azonenberg/stm32mp2-baremetal-tests/pcb/mp2-xc7k-test/mp2-xc7k-test.kicad_pcb

## KiCad design pcb/mp2-xc7k-test/mp2-xc7k-test.kicad_pcb (2025-12-23)

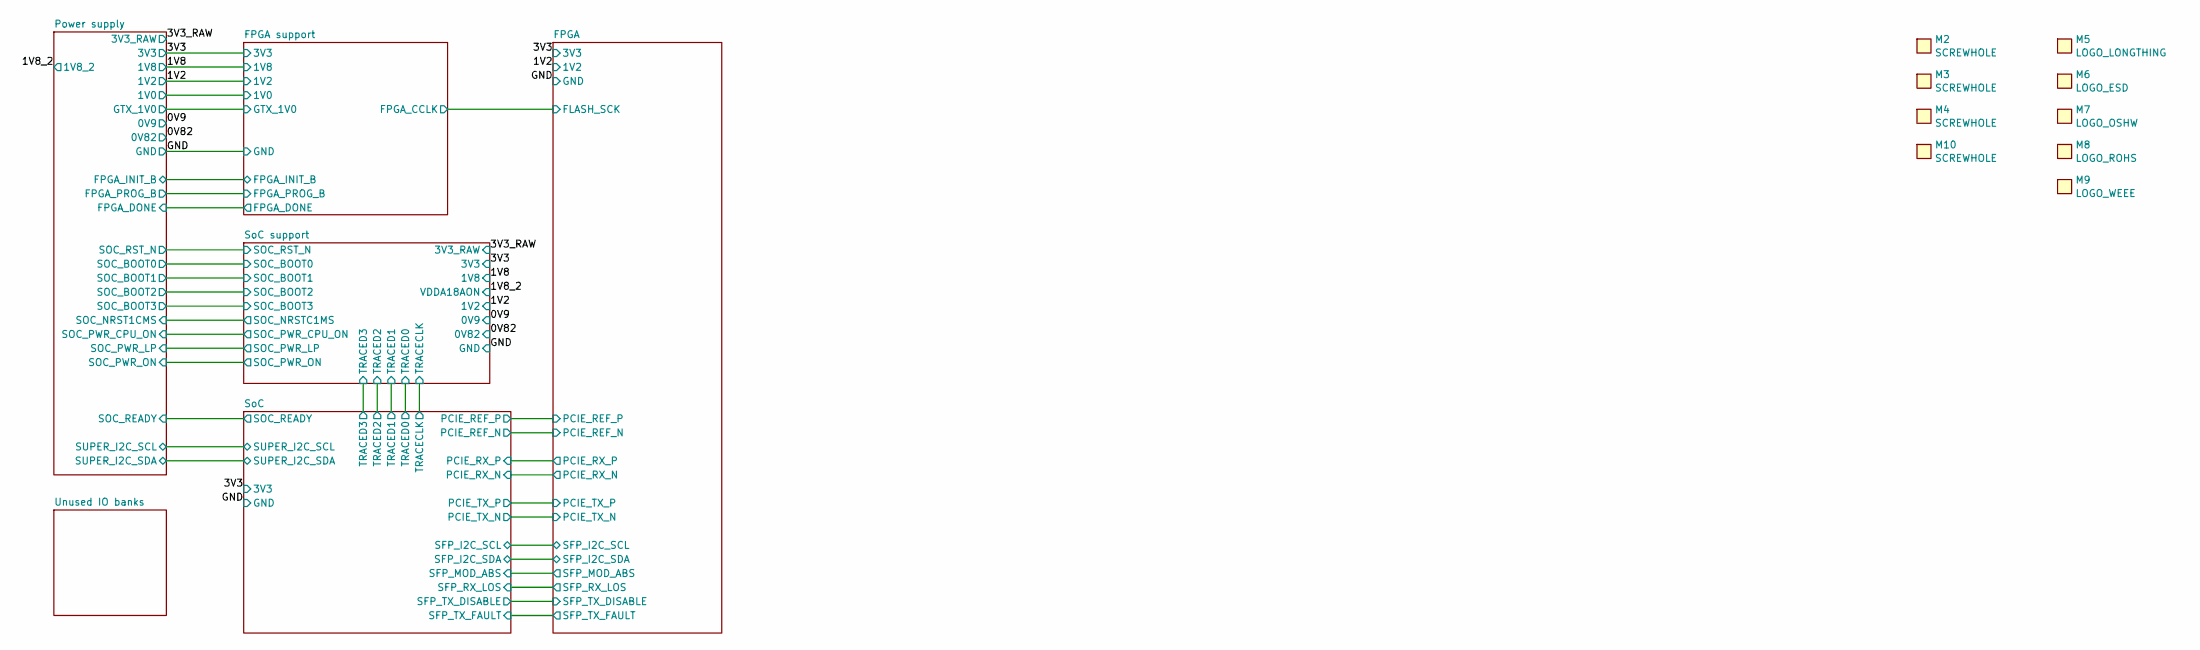
[picture p1: schematic mp2-xc7k-test.kicad_sch]

Parts:
M2, M3, M4, M10: SCREWHOLE; MECHANICAL_CLEARANCEHOLE_4_40
M5: LOGO_LONGTHING; LONGTHING-1200DPI
M6: LOGO_ESD; LOGO_ESD_SENSITIVE_7MM
M7: LOGO_OSHW; Logo_silk_OSHW_6x6mm
M8: LOGO_ROHS; Logo_silk_ROHS_5x2.8mm
M9: LOGO_WEEE; Logo_silk_WEEE_3.4x5mm

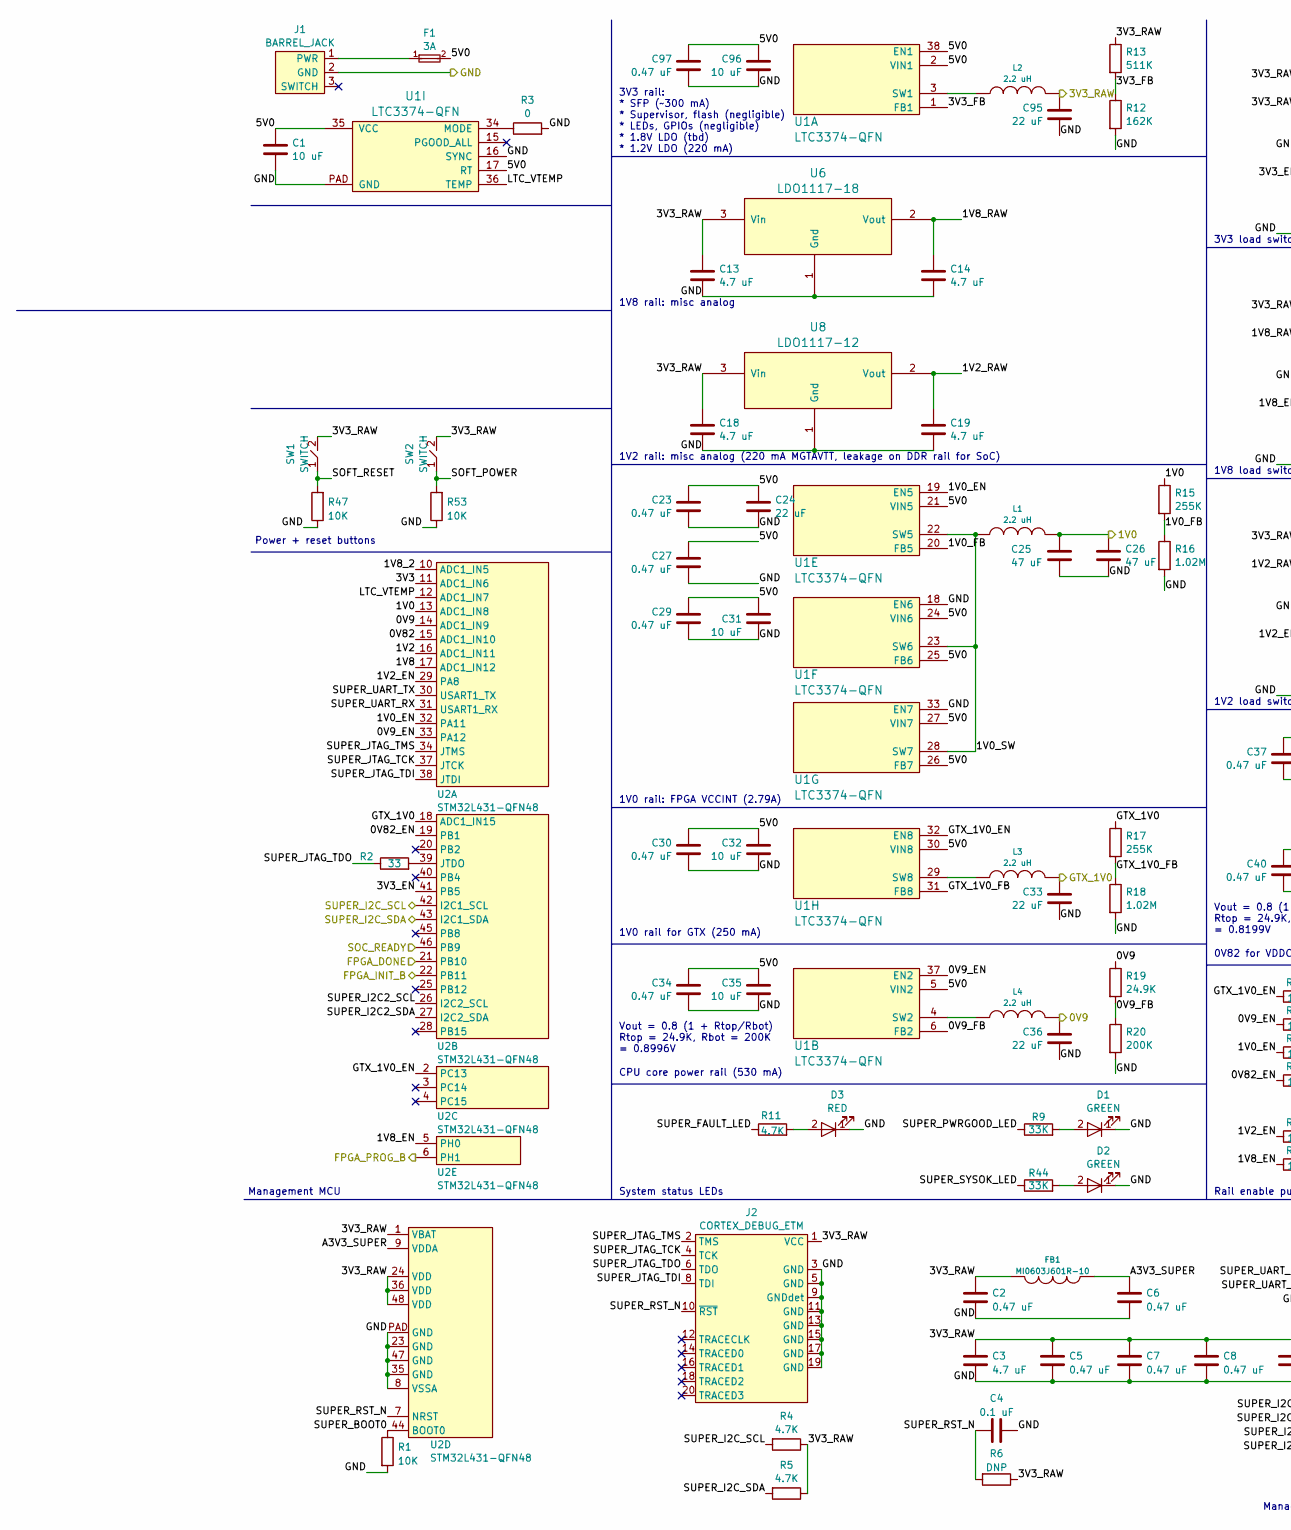
[picture p2: schematic psu.kicad_sch, part in row 1, column 1]

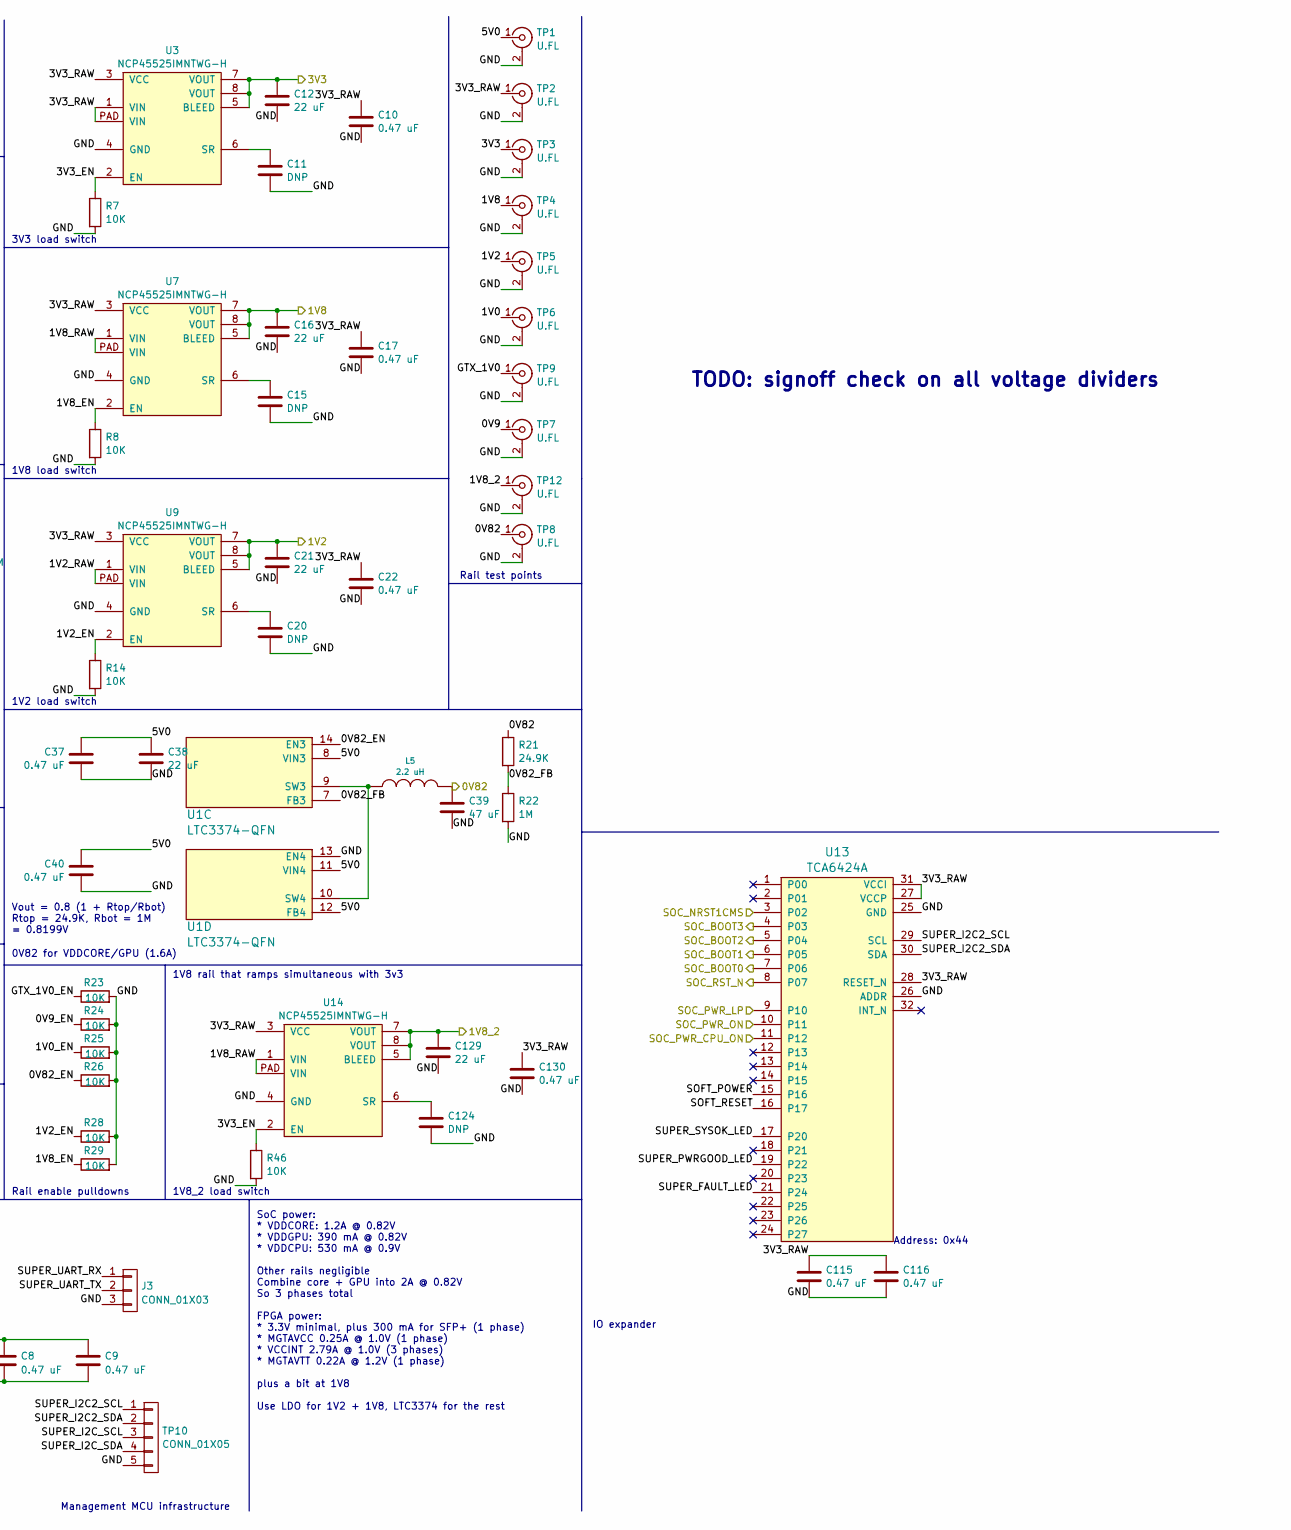
[picture p3: schematic psu.kicad_sch, part in row 1, column 2]

Parts:
C1, C31, C32, C35, C96: 10 uF; EIA_1210_CAP_NOSILK
C2, C5, C6, C7, C8, C9, C10, C17, C22, C23, C27, C29, C30, C34, C37, C40, C97, C115, C116, C130: 0.47 uF; EIA_0402_CAP_NOSILK
C3, C13, C14, C18, C19: 4.7 uF; EIA_0603_CAP_NOSILK
C4: 0.1 uF; EIA_0402_CAP_NOSILK
C11, C15, C20, C124: DNP; EIA_0402_CAP_NOSILK
C12, C16, C21, C24, C38, C129: 22 uF; EIA_1210_CAP_NOSILK
C25, C26, C39: 47 uF; EIA_1206_CAP_NOSILK
C33, C36, C95: 22 uF; EIA_1206_CAP_NOSILK
D1, D2: GREEN; EIA_0402_LED
D3: RED; EIA_0402_LED
F1: 3A; EIA_0402_RES_NOSILK
FB1: MI0603J601R-10; EIA_0603_INDUCTOR_NOSILK
J1: BARREL_JACK; CONN_CUI_PJ-058BH_HIPWR_BARREL_NOSLOT
J2: CORTEX_DEBUG_ETM; CONN_HEADER_1.27MM_2x10_SMT_SAMTEC_FTSH-110-01-L-DV-K
J3: CONN_01X03; CONN_HEADER_2.54MM_1x3
L1, L2, L3, L4, L5: 2.2 uH; EIA_1210_CAP_NOSILK
R1, R7, R8, R14, R23, R24, R25, R26, R28, R29, R46, R47, R53: 10K; EIA_0402_RES_NOSILK
R2: 33; EIA_0402_RES_NOSILK
R3: 0; EIA_0402_RES_NOSILK
R4, R5, R11: 4.7K; EIA_0402_RES_NOSILK
R6: DNP; EIA_0402_RES_NOSILK
R9, R44: 33K; EIA_0402_RES_NOSILK
R12: 162K; EIA_0402_RES_NOSILK
R13: 511K; EIA_0402_RES_NOSILK
R15, R17: 255K; EIA_0402_RES_NOSILK
R16, R18: 1.02M; EIA_0402_RES_NOSILK
R19, R21: 24.9K; EIA_0402_RES_NOSILK
R20: 200K; EIA_0402_RES_NOSILK
R22: 1M; EIA_0402_RES_NOSILK
SW1, SW2: SWITCH; SWITCH_RAFI_MICON_5
TP1, TP2, TP3, TP4, TP5, TP6, TP7, TP8, TP9, TP12: U.FL; CONN_U.FL_TE_1909763-1
TP10: CONN_01X05; CONN_HEADER_2.54MM_1x5_REFLOW
U1: LTC3374-QFN; QFN_38_0.5MM_5x7MM
U2: STM32L431-QFN48; QFN_48_0.5MM_7x7MM
U3, U7, U9, U14: NCP45525IMNTWG-H; DFN_8_0.5MM_2x2MM
U6: LDO1117-18; SOT223-4
U8: LDO1117-12; SOT223-4
U13: TCA6424A; QFN_32_0.5MM_5x5MM

Connections:
/0V9: C36.1, L4.1, R19.1, TP7.1 (In), U2.14 (ADC1_IN9); also elsewhere on the board
/0V82: C39.1, L5.1, R21.1, TP8.1 (In), U2.15 (ADC1_IN10); also elsewhere on the board
/1V2: C21.1, TP5.1 (In), U2.16 (ADC1_IN11), U9.5 (BLEED), U9.7 (VOUT), U9.8 (VOUT); also elsewhere on the board
/1V8: C16.1, TP4.1 (In), U2.17 (ADC1_IN12), U7.5 (BLEED), U7.7 (VOUT), U7.8 (VOUT); also elsewhere on the board
/1V8_2: C129.1, TP12.1 (In), U2.10 (ADC1_IN5), U14.5 (BLEED), U14.7 (VOUT), U14.8 (VOUT); also elsewhere on the board
/3V3: C12.1, TP3.1 (In), U2.11 (ADC1_IN6), U3.5 (BLEED), U3.7 (VOUT), U3.8 (VOUT); also elsewhere on the board
/3V3_RAW: C2.1, C3.1, C5.1, C7.1, C8.1, C9.1, C10.1, C13.1, C17.1, C18.1, C22.1, C95.1, C115.1, C116.1, C130.1, FB1.2, J2.1 (VCC), L2.2, R4.1, R5.1, R6.1, R13.1, SW1.2, SW2.2, TP2.1 (In), U2.1 (VBAT), U2.24 (VDD), U2.36 (VDD), U2.48 (VDD), U3.1 (VIN), U3.3 (VCC), U3.PAD (VIN), U6.3 (Vin), U7.3 (VCC), U8.3 (Vin), U9.3 (VCC), U13.27 (VCCP), U13.28 (RESET_N), U13.31 (VCCI), U14.3 (VCC); also elsewhere on the board
/FPGA support/1V0: C25.1, C26.1, L1.1, R15.1, TP6.1 (In), U2.13 (ADC1_IN8); also elsewhere on the board
/FPGA support/FPGA_DONE: U2.21 (PB10); also elsewhere on the board
/FPGA support/FPGA_INIT_B: U2.22 (PB11); also elsewhere on the board
/FPGA support/FPGA_PROG_B: U2.6 (PH1); also elsewhere on the board
/FPGA support/GTX_1V0: C33.1, L3.1, R17.1, TP9.1 (In), U2.18 (ADC1_IN15); also elsewhere on the board
/GND: C1.2, C2.2, C3.2, C4.2, C5.2, C6.2, C7.2, C8.2, C9.2, C10.2, C11.2, C12.2, C13.2, C14.2, C15.2, C16.2, C17.2, C18.2, C19.2, C20.2, C21.2, C22.2, C23.2, C24.2, C25.2, C26.2, C27.2, C29.2, C30.2, C31.2, C32.2, C33.2, C34.2, C35.2, C36.2, C37.2, C38.2, C39.2, C40.2, C95.2, C96.2, C97.2, C115.2, C116.2, C124.2, C129.2, C130.2, D1.1 (K), D2.1 (K), D3.1 (K), J1.2 (GND), J2.3 (GND), J2.5 (GND), J2.9 (GNDdet), J2.11 (GND), J2.13 (GND), J2.15 (GND), J2.17 (GND), J2.19 (GND), J3.3, R1.2, R3.2, R7.2, R8.2, R12.2, R14.2, R16.2, R18.2, R20.2, R22.2, R23.2, R24.2, R25.2, R26.2, R28.2, R29.2, R46.2, R47.1, R53.1, TP1.2 (Ext), TP2.2 (Ext), TP3.2 (Ext), TP4.2 (Ext), TP5.2 (Ext), TP6.2 (Ext), TP7.2 (Ext), TP8.2 (Ext), TP9.2 (Ext), TP10.5, TP12.2 (Ext), U1.13 (EN4), U1.16 (SYNC), U1.18 (EN6), U1.33 (EN7), U1.PAD (GND), U2.8 (VSSA), U2.23 (GND), U2.35 (GND), U2.47 (GND), U2.PAD (GND), U3.4 (GND), U6.1 (Gnd), U7.4 (GND), U8.1 (Gnd), U9.4 (GND), U13.25 (GND), U13.26 (ADDR), U14.4 (GND); also elsewhere on the board
/Power supply/0V9_EN: R24.1, U1.37 (EN2), U2.33 (PA12)
/Power supply/0V9_FB: R19.2, R20.1, U1.6 (FB2)
/Power supply/0V82_EN: R26.1, U1.14 (EN3), U2.19 (PB1)
/Power supply/0V82_FB: R21.2, R22.1, U1.7 (FB3)
/Power supply/1V0_EN: R25.1, U1.19 (EN5), U2.32 (PA11)
/Power supply/1V0_FB: R15.2, R16.1, U1.20 (FB5)
/Power supply/1V0_SW: L1.2, U1.22 (SW5), U1.23 (SW6), U1.28 (SW7)
/Power supply/1V2_EN: R14.1, R28.1, U2.29 (PA8), U9.2 (EN)
/Power supply/1V2_RAW: C19.1, U8.2 (Vout), U9.1 (VIN), U9.PAD (VIN)
/Power supply/1V8_EN: R8.1, R29.1, U2.5 (PH0), U7.2 (EN)
/Power supply/1V8_RAW: C14.1, U6.2 (Vout), U7.1 (VIN), U7.PAD (VIN), U14.1 (VIN), U14.PAD (VIN)
/Power supply/3V3_EN: R7.1, R46.1, U2.41 (PB5), U3.2 (EN), U14.2 (EN)
/Power supply/3V3_FB: R12.1, R13.2, U1.1 (FB1)
/Power supply/5V0: C1.1, C23.1, C24.1, C27.1, C29.1, C30.1, C31.1, C32.1, C34.1, C35.1, C37.1, C38.1, C40.1, C96.1, C97.1, F1.2, TP1.1 (In), U1.2 (VIN1), U1.5 (VIN2), U1.8 (VIN3), U1.11 (VIN4), U1.12 (FB4), U1.17 (RT), U1.21 (VIN5), U1.24 (VIN6), U1.25 (FB6), U1.26 (FB7), U1.27 (VIN7), U1.30 (VIN8), U1.35 (VCC), U1.38 (EN1)
/Power supply/A3V3_SUPER: C6.1, FB1.1, U2.9 (VDDA)
/Power supply/GTX_1V0_EN: R23.1, U1.32 (EN8), U2.2 (PC13)
/Power supply/GTX_1V0_FB: R17.2, R18.1, U1.31 (FB8)
/Power supply/LTC_VTEMP: U1.36 (TEMP), U2.12 (ADC1_IN7)
/Power supply/SOC_BOOT0: U13.7 (P06); also elsewhere on the board
/Power supply/SOC_BOOT1: U13.6 (P05); also elsewhere on the board
/Power supply/SOC_BOOT2: U13.5 (P04); also elsewhere on the board
/Power supply/SOC_BOOT3: U13.4 (P03); also elsewhere on the board
/Power supply/SOC_NRST1CMS: U13.3 (P02); also elsewhere on the board
/Power supply/SOC_PWR_CPU_ON: U13.11 (P12); also elsewhere on the board
/Power supply/SOC_PWR_LP: U13.9 (P10); also elsewhere on the board
/Power supply/SOC_PWR_ON: U13.10 (P11); also elsewhere on the board
/Power supply/SOC_READY: U2.46 (PB9); also elsewhere on the board
/Power supply/SOFT_POWER: R53.2, SW2.1, U13.15 (P16)
/Power supply/SOFT_RESET: R47.2, SW1.1, U13.16 (P17)
/Power supply/SUPER_BOOT0: R1.1, U2.44 (BOOT0)
/Power supply/SUPER_FAULT_LED: R11.1, U13.21 (P24)
/Power supply/SUPER_I2C2_SCL: TP10.1, U2.26 (I2C2_SCL), U13.29 (SCL)
/Power supply/SUPER_I2C2_SDA: TP10.2, U2.27 (I2C2_SDA), U13.30 (SDA)
/Power supply/SUPER_I2C_SCL: R4.2, TP10.3, U2.42 (I2C1_SCL); also elsewhere on the board
/Power supply/SUPER_I2C_SDA: R5.2, TP10.4, U2.43 (I2C1_SDA); also elsewhere on the board
/Power supply/SUPER_JTAG_TCK: J2.4 (TCK), U2.37 (JTCK)
/Power supply/SUPER_JTAG_TDI: J2.8 (TDI), U2.38 (JTDI)
/Power supply/SUPER_JTAG_TDO: J2.6 (TDO), R2.1
/Power supply/SUPER_JTAG_TMS: J2.2 (TMS), U2.34 (JTMS)
/Power supply/SUPER_PWRGOOD_LED: R9.1, U13.19 (P22)
/Power supply/SUPER_RST_N: C4.1, J2.10 (~RST), R6.2, U2.7 (NRST)
/Power supply/SUPER_SYSOK_LED: R44.1, U13.17 (P20)
/Power supply/SUPER_UART_RX: J3.1, U2.31 (USART1_RX)
/Power supply/SUPER_UART_TX: J3.2, U2.30 (USART1_TX)
/SoC support/SOC_RST_N: U13.8 (P07); also elsewhere on the board
unnamed: D1.2 (A), R9.2
unnamed: D2.2 (A), R44.2
unnamed: D3.2 (A), R11.2
unnamed: F1.1, J1.1 (PWR)
unnamed: L2.1, U1.3 (SW1)
unnamed: L4.2, U1.4 (SW2)
unnamed: L5.2, U1.9 (SW3), U1.10 (SW4)
unnamed: L3.2, U1.29 (SW8)
unnamed: R3.1, U1.34 (MODE)
unnamed: R2.2, U2.39 (JTDO)
unnamed: C11.1, U3.6 (SR)
unnamed: C15.1, U7.6 (SR)
unnamed: C20.1, U9.6 (SR)
unnamed: C124.1, U14.6 (SR)

Notes on the sheet:
Address: 0x44
1V0 rail for GTX (250 mA)
1V2 load switch
Rail test points
1V8 rail: misc analog
1V8_2 load switch
Management MCU
System status LEDs
3V3 rail: * SFP (~300 mA) * Supervisor, flash (negligible) * LEDs, GPIOs (negligible) * 1.8V LDO (tbd) * 1.2V LDO (220 mA)
Vout = 0.8 (1 + Rtop/Rbot) Rtop = 24.9K, Rbot = 1M = 0.8199V
3V3 load switch
Management MCU infrastructure
IO expander
1V0 rail: FPGA VCCINT (2.79A)
TODO: signoff check on all voltage dividers
Rail enable pulldowns
1V8 rail that ramps simultaneous with 3v3
Vout = 0.8 (1 + Rtop/Rbot) Rtop = 24.9K, Rbot = 200K = 0.8996V
SoC power: * VDDCORE: 1.2A @ 0.82V * VDDGPU: 390 mA @ 0.82V * VDDCPU: 530 mA @ 0.9V Other rails negligible Combine core + GPU into 2A @ 0.82V So 3 phases total FPGA power: * 3.3V minimal, plus 300 mA for SFP+ (1 phase) * MGTAVCC 0.25A @ 1.0V (1 phase) * VCCINT 2.79A @ 1.0V (3 phases) * MGTAVTT 0.22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
1V2 rail: misc analog (220 mA MGTAVTT, leakage on DDR rail for SoC)
0V82 for VDDCORE/GPU (1.6A)
CPU core power rail (530 mA)
Power + reset buttons
1V8 load switch

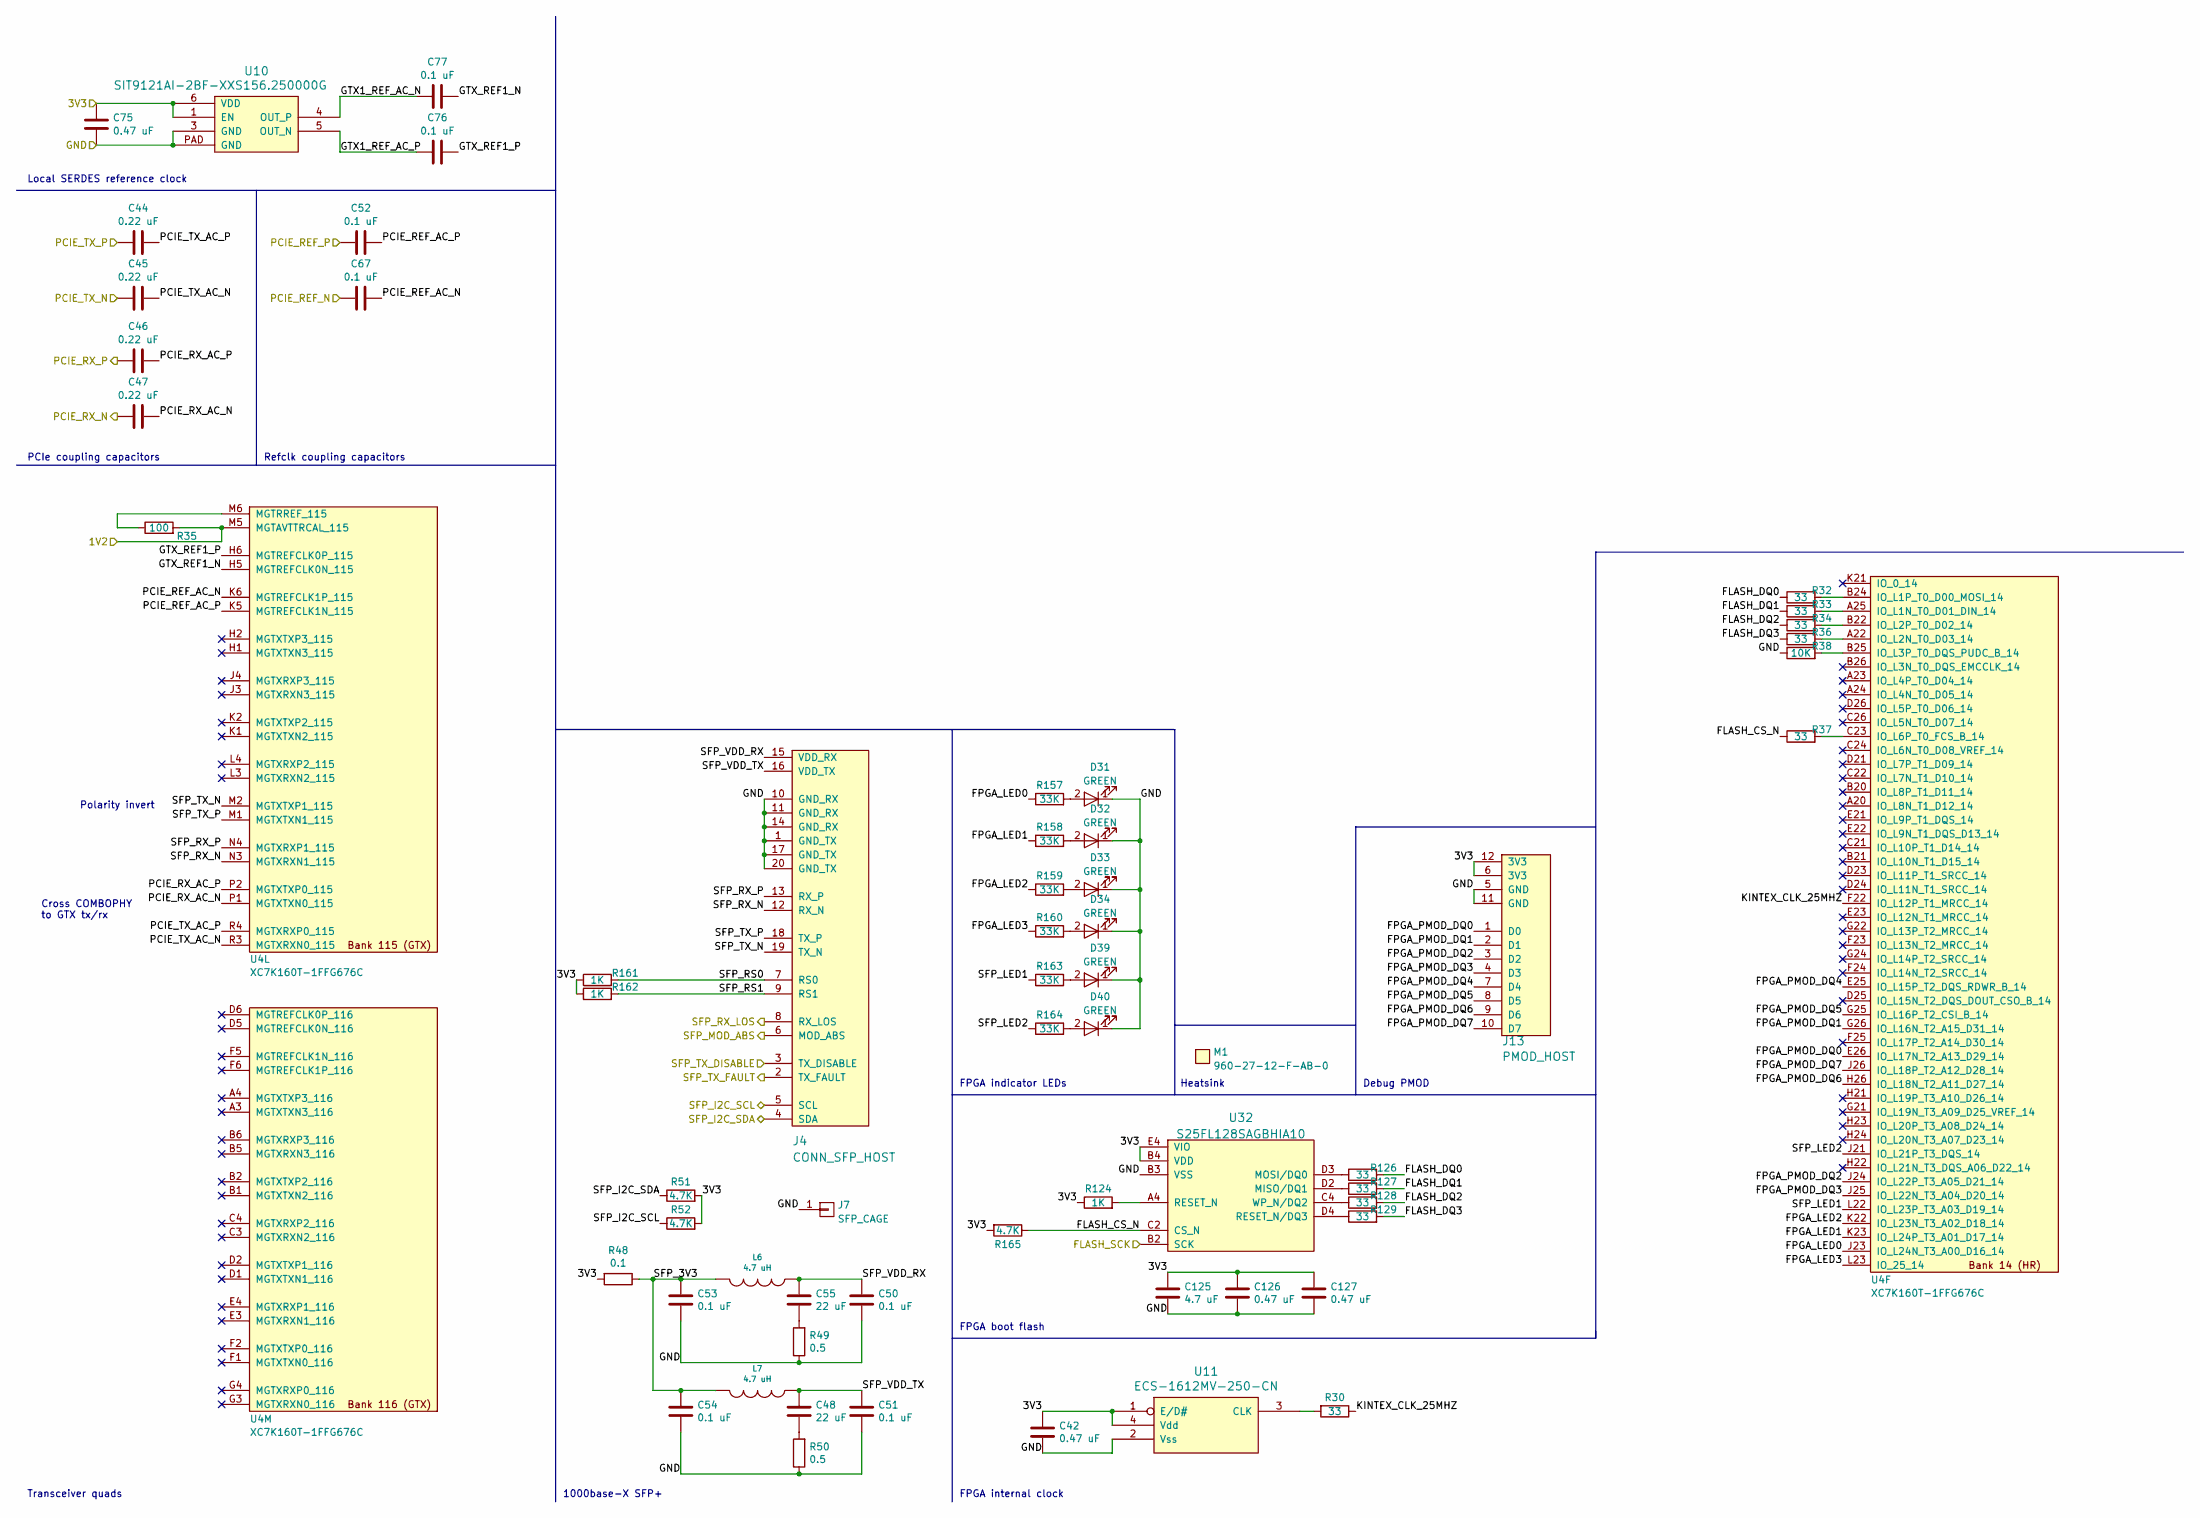
[picture p4: schematic fpga.kicad_sch]

Parts:
C42, C75, C126, C127: 0.47 uF; EIA_0402_CAP_NOSILK
C44, C45, C46, C47: 0.22 uF; EIA_0402_CAP_NOSILK
C48, C55: 22 uF; EIA_0805_CAP_NOSILK
C50, C51, C52, C53, C54, C67, C76, C77: 0.1 uF; EIA_0402_CAP_NOSILK
C125: 4.7 uF; EIA_0603_CAP_NOSILK
D31, D32, D33, D34, D39, D40: GREEN; EIA_0402_LED
J4: CONN_SFP_HOST; CONN_SFP+_AMPHENOL_UE76_A10_2000T
J7: SFP_CAGE; CONN_SFP_CAGE_TE_2007194-1
J13: PMOD_HOST; CONN_HEADER_2.54MM_2x6_RA_PMOD_HOST
L6, L7: 4.7 uH; EIA_0805_INDUCTOR_NOSILK
M1: 960-27-12-F-AB-0; HEATSINK_WAKEFIELDVETTE_960-27-12-D-AB-0
R30, R32, R33, R34, R36, R37, R126, R127, R128, R129: 33; EIA_0402_RES_NOSILK
R35: 100; EIA_0402_RES_NOSILK
R38: 10K; EIA_0402_RES_NOSILK
R48: 0.1; EIA_0402_RES_NOSILK
R49, R50: 0.5; EIA_0402_RES_NOSILK
R51, R52, R165: 4.7K; EIA_0402_RES_NOSILK
R124, R161, R162: 1K; EIA_0402_RES_NOSILK
R157, R158, R159, R160, R163, R164: 33K; EIA_0402_RES_NOSILK
U4: XC7K160T-1FFG676C; BGA_676_27x27_FULLARRAY_1MM_FFG676
U10: SIT9121AI-2BF-XXS156.250000G; OSCILLATOR_LVDS_3.2x2.5
U11: ECS-1612MV-250-CN; OSCILLATOR_1.6x1.2
U32: S25FL128SAGBHIA10; BGA_24_6x8_DEPOP1_1MM

Connections:
/1V2: R35.2, U4.M5 (MGTAVTTRCAL_115); also elsewhere on the board
/3V3: C42.1, C75.1, C125.1, C126.1, C127.1, J13.6 (3V3), J13.12 (3V3), R48.2, R51.2, R52.2, R124.1, R161.1, R162.1, R165.2, U10.1 (EN), U10.6 (VDD), U11.1 (E/D#), U11.4 (Vdd), U32.B4 (VDD), U32.E4 (VIO); also elsewhere on the board
/FPGA support/FPGA_CCLK: U32.B2 (SCK); also elsewhere on the board
/FPGA/FLASH_CS_N: R37.1, R165.1, U32.C2 (CS_N)
/FPGA/FLASH_DQ0: R32.1, R126.2
/FPGA/FLASH_DQ1: R33.1, R127.2
/FPGA/FLASH_DQ2: R34.1, R128.2
/FPGA/FLASH_DQ3: R36.1, R129.2
/FPGA/FPGA_LED0: R157.1, U4.J23 (IO_L24N_T3_A00_D16_14)
/FPGA/FPGA_LED1: R158.1, U4.K23 (IO_L24P_T3_A01_D17_14)
/FPGA/FPGA_LED2: R159.1, U4.K22 (IO_L23N_T3_A02_D18_14)
/FPGA/FPGA_LED3: R160.1, U4.L23 (IO_25_14)
/FPGA/FPGA_PMOD_DQ0: J13.1 (D0), U4.E26 (IO_L17N_T2_A13_D29_14)
/FPGA/FPGA_PMOD_DQ1: J13.2 (D1), U4.G26 (IO_L16N_T2_A15_D31_14)
/FPGA/FPGA_PMOD_DQ2: J13.3 (D2), U4.J24 (IO_L22P_T3_A05_D21_14)
/FPGA/FPGA_PMOD_DQ3: J13.4 (D3), U4.J25 (IO_L22N_T3_A04_D20_14)
/FPGA/FPGA_PMOD_DQ4: J13.7 (D4), U4.E25 (IO_L15P_T2_DQS_RDWR_B_14)
/FPGA/FPGA_PMOD_DQ5: J13.8 (D5), U4.G25 (IO_L16P_T2_CSI_B_14)
/FPGA/FPGA_PMOD_DQ6: J13.9 (D6), U4.H26 (IO_L18N_T2_A11_D27_14)
/FPGA/FPGA_PMOD_DQ7: J13.10 (D7), U4.J26 (IO_L18P_T2_A12_D28_14)
/FPGA/GTX1_REF_AC_N: C77.1, U10.4 (OUT_P)
/FPGA/GTX1_REF_AC_P: C76.1, U10.5 (OUT_N)
/FPGA/GTX_REF1_N: C77.2, U4.H5 (MGTREFCLK0N_115)
/FPGA/GTX_REF1_P: C76.2, U4.H6 (MGTREFCLK0P_115)
/FPGA/KINTEX_CLK_25MHZ: R30.1, U4.F22 (IO_L12P_T1_MRCC_14)
/FPGA/PCIE_REF_AC_N: C67.2, U4.K6 (MGTREFCLK1P_115)
/FPGA/PCIE_REF_AC_P: C52.2, U4.K5 (MGTREFCLK1N_115)
/FPGA/PCIE_REF_N: C67.1; also elsewhere on the board
/FPGA/PCIE_REF_P: C52.1; also elsewhere on the board
/FPGA/PCIE_RX_AC_N: C47.2, U4.P1 (MGTXTXN0_115)
/FPGA/PCIE_RX_AC_P: C46.2, U4.P2 (MGTXTXP0_115)
/FPGA/PCIE_RX_N: C47.1; also elsewhere on the board
/FPGA/PCIE_RX_P: C46.1; also elsewhere on the board
/FPGA/PCIE_TX_AC_N: C45.2, U4.R3 (MGTXRXN0_115)
/FPGA/PCIE_TX_AC_P: C44.2, U4.R4 (MGTXRXP0_115)
/FPGA/PCIE_TX_N: C45.1; also elsewhere on the board
/FPGA/PCIE_TX_P: C44.1; also elsewhere on the board
/FPGA/SFP_3V3: C53.1, C54.1, L6.2, L7.2, R48.1
/FPGA/SFP_I2C_SCL: J4.5 (SCL), R52.1; also elsewhere on the board
/FPGA/SFP_I2C_SDA: J4.4 (SDA), R51.1; also elsewhere on the board
/FPGA/SFP_LED1: R163.1, U4.L22 (IO_L23P_T3_A03_D19_14)
/FPGA/SFP_LED2: R164.1, U4.J21 (IO_L21P_T3_DQS_14)
/FPGA/SFP_MOD_ABS: J4.6 (MOD_ABS); also elsewhere on the board
/FPGA/SFP_RS0: J4.7 (RS0), R161.2
/FPGA/SFP_RS1: J4.9 (RS1), R162.2
/FPGA/SFP_RX_LOS: J4.8 (RX_LOS); also elsewhere on the board
/FPGA/SFP_RX_N: J4.12 (RX_N), U4.N3 (MGTXRXN1_115)
/FPGA/SFP_RX_P: J4.13 (RX_P), U4.N4 (MGTXRXP1_115)
/FPGA/SFP_TX_DISABLE: J4.3 (TX_DISABLE); also elsewhere on the board
/FPGA/SFP_TX_FAULT: J4.2 (TX_FAULT); also elsewhere on the board
/FPGA/SFP_TX_N: J4.19 (TX_N), U4.M2 (MGTXTXP1_115)
/FPGA/SFP_TX_P: J4.18 (TX_P), U4.M1 (MGTXTXN1_115)
/FPGA/SFP_VDD_RX: C50.1, C55.1, J4.15 (VDD_RX), L6.1
/FPGA/SFP_VDD_TX: C48.1, C51.1, J4.16 (VDD_TX), L7.1
/GND: C42.2, C50.2, C51.2, C53.2, C54.2, C75.2, C125.2, C126.2, C127.2, D31.1 (K), D32.1 (K), D33.1 (K), D34.1 (K), D39.1 (K), D40.1 (K), J4.1 (GND_TX), J4.10 (GND_RX), J4.11 (GND_RX), J4.14 (GND_RX), J4.17 (GND_TX), J4.20 (GND_TX), J7.1, J13.5 (GND), J13.11 (GND), R38.1, R49.1, R50.1, U10.3 (GND), U10.PAD (GND), U11.2 (Vss), U32.B3 (VSS); also elsewhere on the board
unnamed: C48.2, R50.2
unnamed: C55.2, R49.2
unnamed: D31.2 (A), R157.2
unnamed: D32.2 (A), R158.2
unnamed: D33.2 (A), R159.2
unnamed: D34.2 (A), R160.2
unnamed: D39.2 (A), R163.2
unnamed: D40.2 (A), R164.2
unnamed: R33.2, U4.A25 (IO_L1N_T0_D01_DIN_14)
unnamed: R32.2, U4.B24 (IO_L1P_T0_D00_MOSI_14)
unnamed: R36.2, U4.A22 (IO_L2N_T0_D03_14)
unnamed: R34.2, U4.B22 (IO_L2P_T0_D02_14)
unnamed: R38.2, U4.B25 (IO_L3P_T0_DQS_PUDC_B_14)
unnamed: R37.2, U4.C23 (IO_L6P_T0_FCS_B_14)
unnamed: R35.1, U4.M6 (MGTRREF_115)
unnamed: R30.2, U11.3 (CLK)
unnamed: R127.1, U32.D2 (MISO/DQ1)
unnamed: R126.1, U32.D3 (MOSI/DQ0)
unnamed: R124.2, U32.A4 (RESET_N)
unnamed: R129.1, U32.D4 (RESET_N/DQ3)
unnamed: R128.1, U32.C4 (WP_N/DQ2)

Notes on the sheet:
Polarity invert
Refclk coupling capacitors
PCIe coupling capacitors
Debug PMOD
FPGA indicator LEDs
Transceiver quads
FPGA internal clock
FPGA boot flash
1000base-X SFP+
Cross COMBOPHY to GTX tx/rx
Local SERDES reference clock
Heatsink

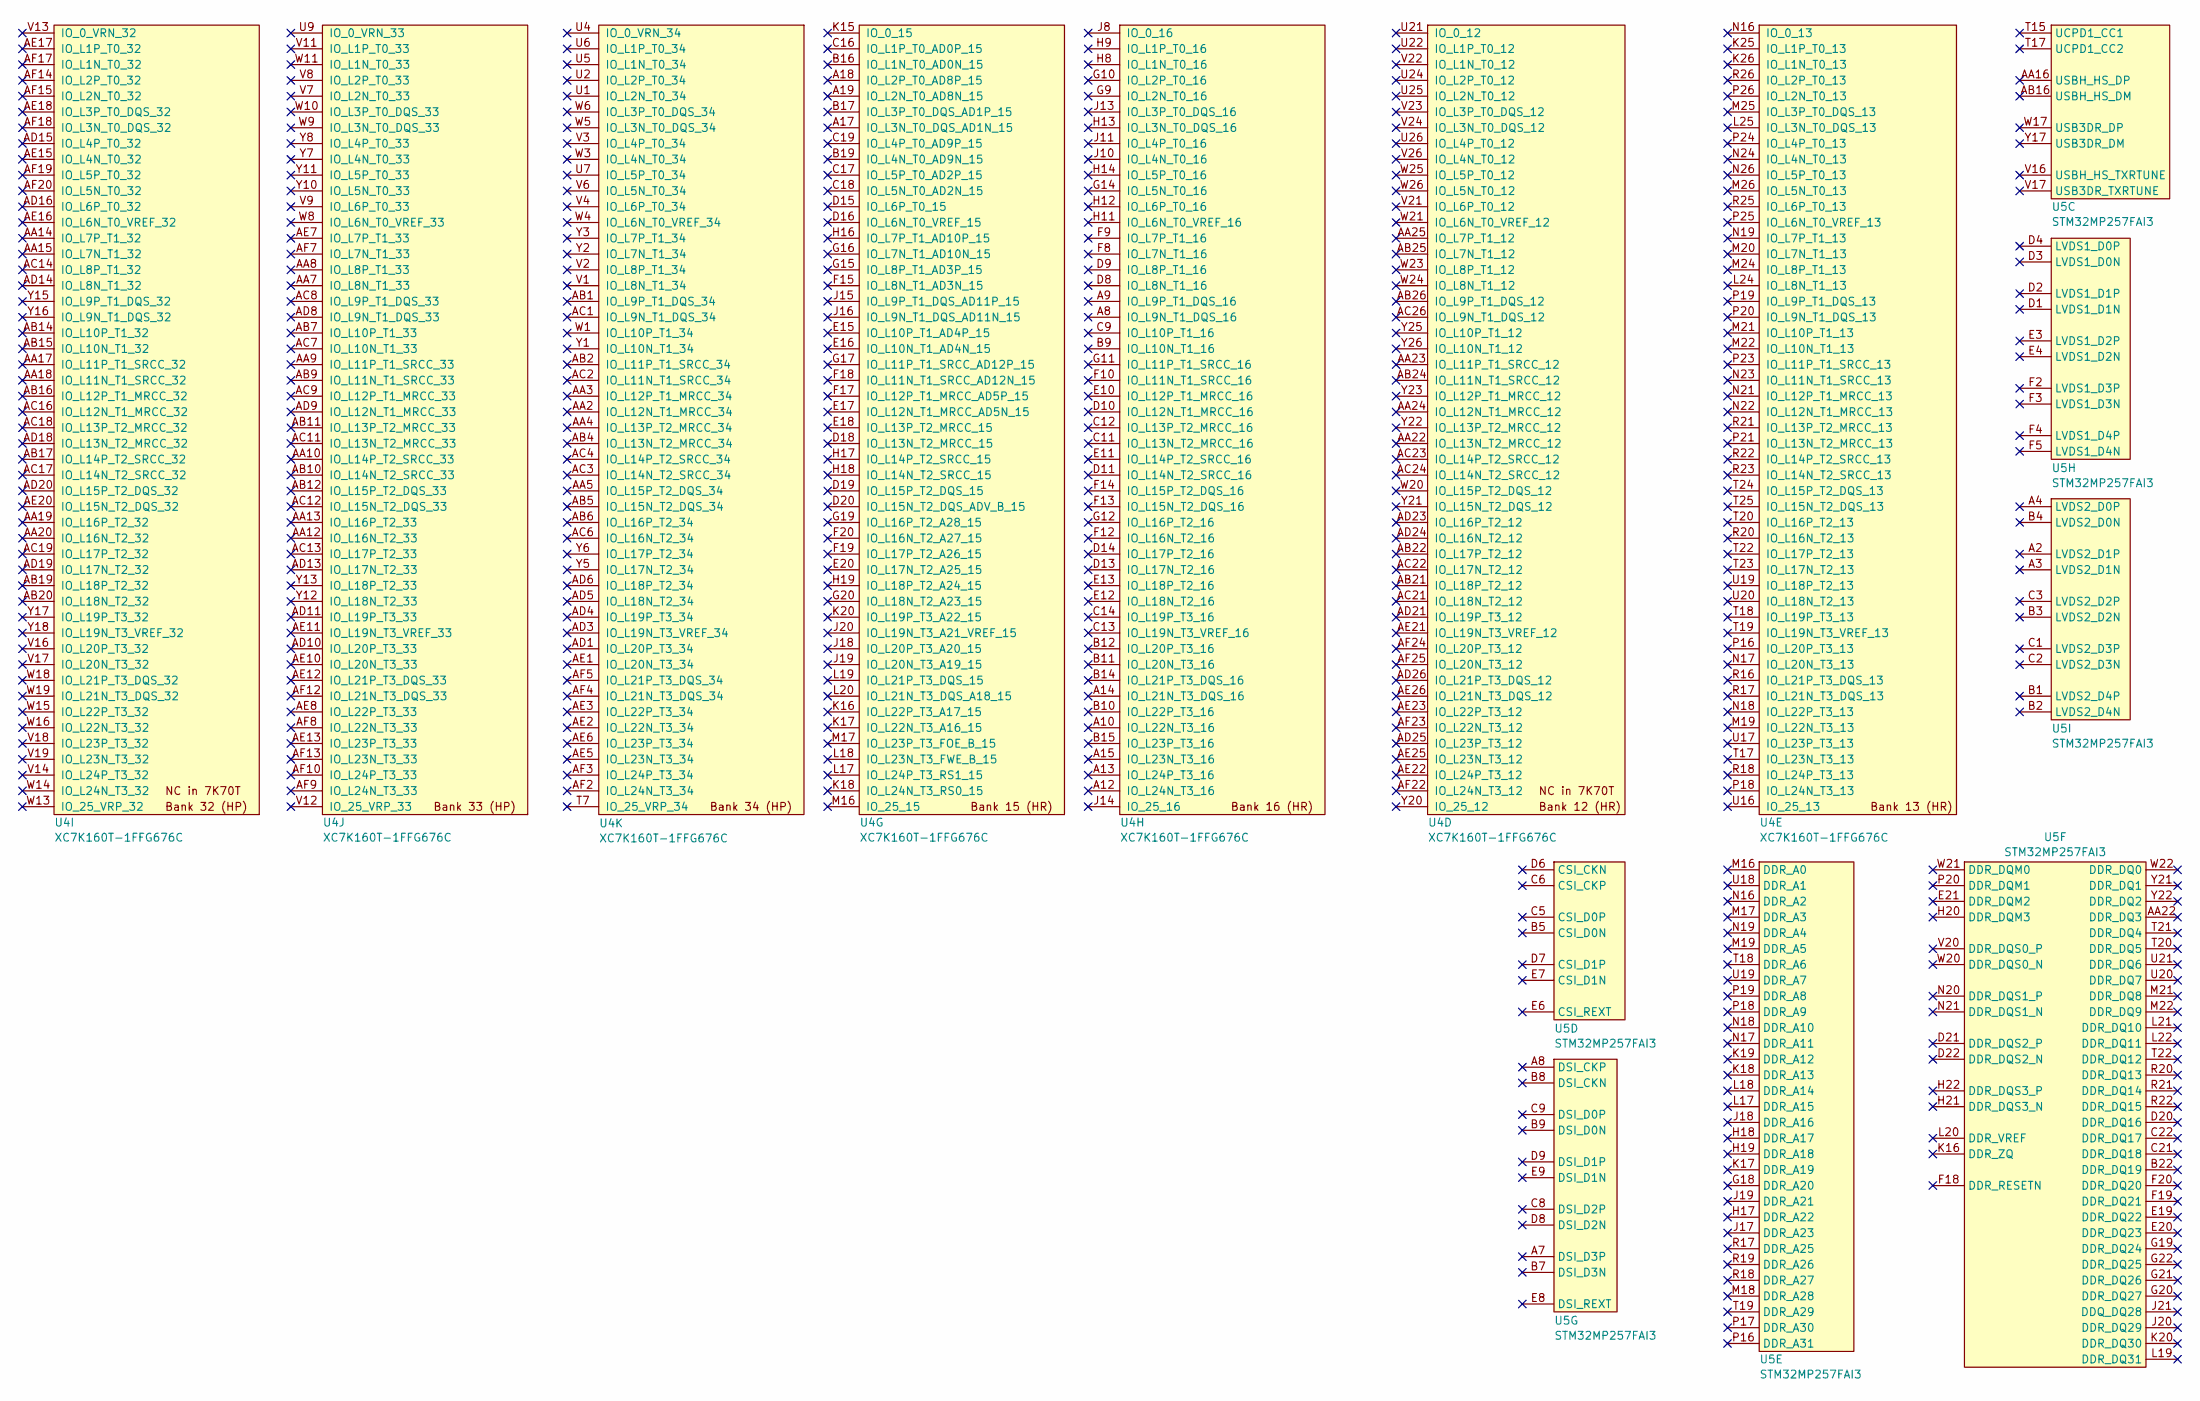
[picture p5: schematic unused-io.kicad_sch]

Parts:
U4: XC7K160T-1FFG676C; BGA_676_27x27_FULLARRAY_1MM_FFG676
U5: STM32MP257FAI3; BGA_436_18x18_DEPOP_0.8MM
