azonenberg/stm32mp2-baremetal-tests/pcb/mp2-xc7k-test/mp2-xc7k-test.kicad_pcb

## KiCad design pcb/mp2-xc7k-test/mp2-xc7k-test.kicad_pcb (continued)

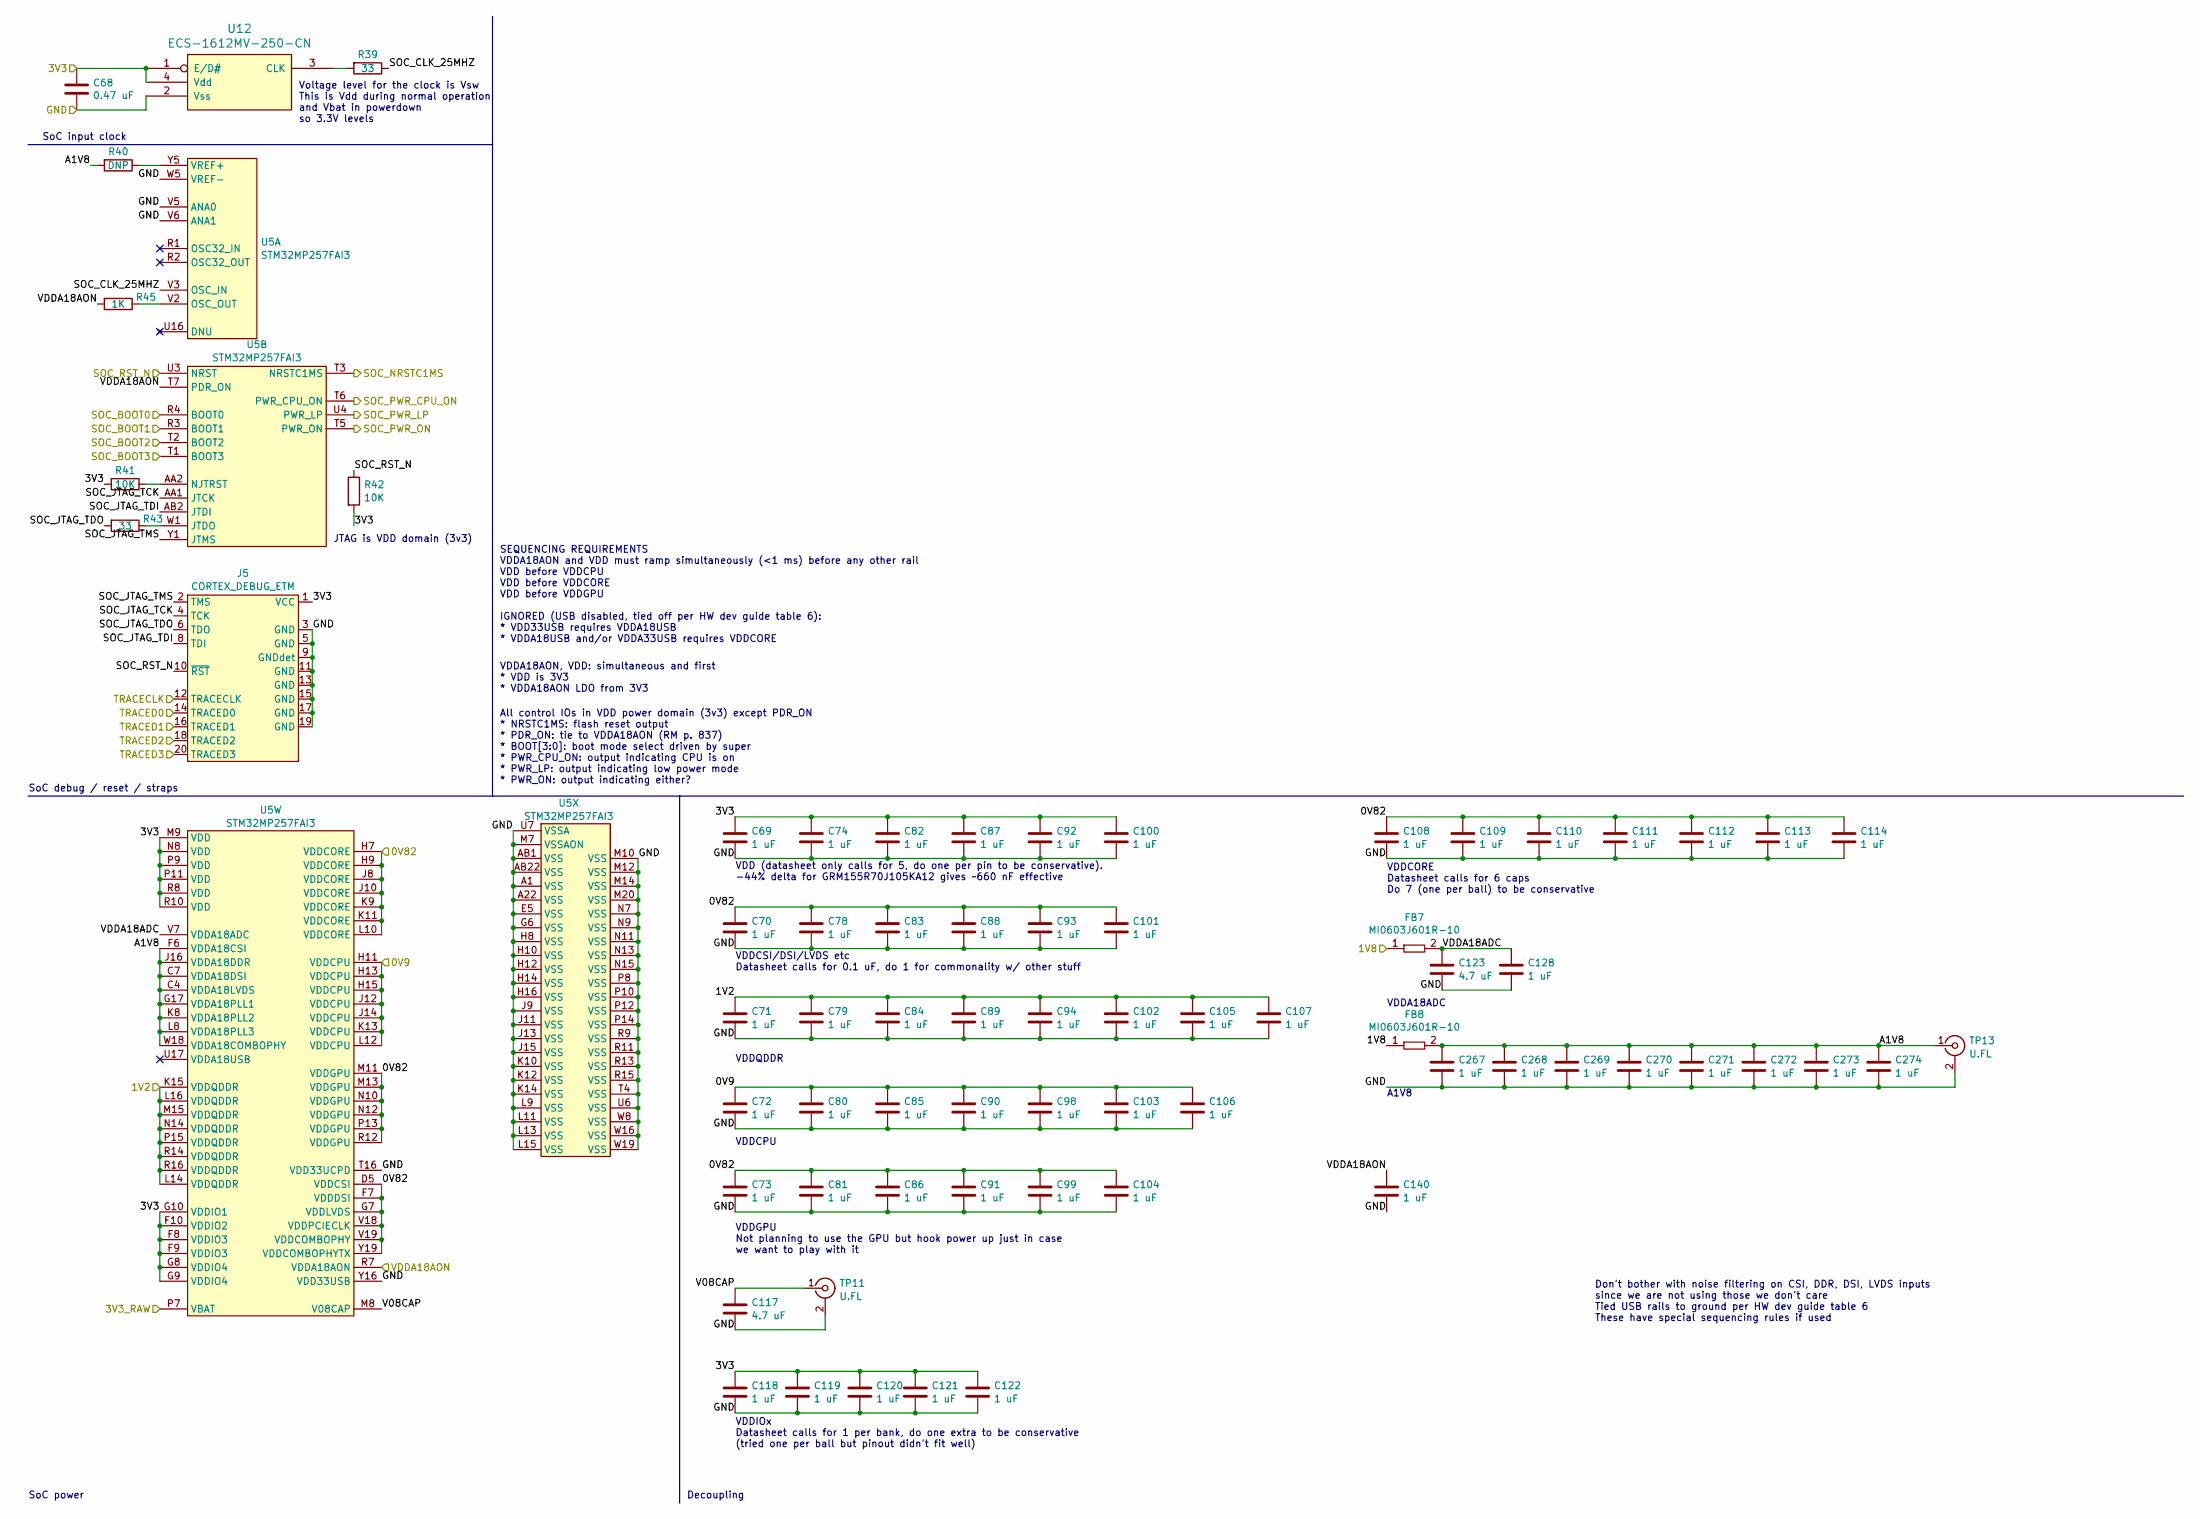
[picture p6: schematic socsupport.kicad_sch]

Parts:
C68: 0.47 uF; EIA_0402_CAP_NOSILK
C69, C70, C71, C72, C73, C74, C78, C79, C80, C81, C82, C83, C84, C85, C86, C87, C88, C89, C90, C91, C92, C93, C94, C98, C99, C100, C101, C102, C103, C104, C105, C106, C107, C108, C109, C110, C111, C112, C113, C114, C118, C119, C120, C121, C122, C128, C140, C267, C268, C269, C270, C271, C272, C273, C274: 1 uF; EIA_0201_CAP_NOSILK
C117, C123: 4.7 uF; EIA_0603_CAP_NOSILK
FB7, FB8: MI0603J601R-10; EIA_0603_INDUCTOR_NOSILK
J5: CORTEX_DEBUG_ETM; CONN_HEADER_1.27MM_2x10_SMT_SAMTEC_FTSH-110-01-L-DV-K
R39, R43: 33; EIA_0402_RES_NOSILK
R40: DNP; EIA_0402_RES_NOSILK
R41, R42: 10K; EIA_0402_RES_NOSILK
R45: 1K; EIA_0402_RES_NOSILK
TP11, TP13: U.FL; CONN_U.FL_TE_1909763-1
U5: STM32MP257FAI3; BGA_436_18x18_DEPOP_0.8MM
U12: ECS-1612MV-250-CN; OSCILLATOR_1.6x1.2

Connections:
/0V9: C72.1, C80.1, C85.1, C90.1, C98.1, C103.1, C106.1, U5.H11 (VDDCPU), U5.H13 (VDDCPU), U5.H15 (VDDCPU), U5.J12 (VDDCPU), U5.J14 (VDDCPU), U5.K13 (VDDCPU), U5.L12 (VDDCPU); also elsewhere on the board
/0V82: C70.1, C73.1, C78.1, C81.1, C83.1, C86.1, C88.1, C91.1, C93.1, C99.1, C101.1, C104.1, C108.1, C109.1, C110.1, C111.1, C112.1, C113.1, C114.1, U5.D5 (VDDCSI), U5.F7 (VDDDSI), U5.G7 (VDDLVDS), U5.H7 (VDDCORE), U5.H9 (VDDCORE), U5.J8 (VDDCORE), U5.J10 (VDDCORE), U5.K9 (VDDCORE), U5.K11 (VDDCORE), U5.L10 (VDDCORE), U5.M11 (VDDGPU), U5.M13 (VDDGPU), U5.N10 (VDDGPU), U5.N12 (VDDGPU), U5.P13 (VDDGPU), U5.R12 (VDDGPU), U5.V18 (VDDPCIECLK), U5.V19 (VDDCOMBOPHY), U5.Y19 (VDDCOMBOPHYTX); also elsewhere on the board
/1V2: C71.1, C79.1, C84.1, C89.1, C94.1, C102.1, C105.1, C107.1, U5.K15 (VDDQDDR), U5.L14 (VDDQDDR), U5.L16 (VDDQDDR), U5.M15 (VDDQDDR), U5.N14 (VDDQDDR), U5.P15 (VDDQDDR), U5.R14 (VDDQDDR), U5.R16 (VDDQDDR); also elsewhere on the board
/1V8: FB7.1, FB8.1; also elsewhere on the board
/1V8_2: C140.1, R45.2, U5.R7 (VDDA18AON), U5.T7 (PDR_ON); also elsewhere on the board
/3V3: C68.1, C69.1, C74.1, C82.1, C87.1, C92.1, C100.1, C118.1, C119.1, C120.1, C121.1, C122.1, J5.1 (VCC), R41.2, R42.2, U5.F8 (VDDIO3), U5.F9 (VDDIO3), U5.F10 (VDDIO2), U5.G8 (VDDIO4), U5.G9 (VDDIO4), U5.G10 (VDDIO1), U5.M9 (VDD), U5.N8 (VDD), U5.P9 (VDD), U5.P11 (VDD), U5.R8 (VDD), U5.R10 (VDD), U12.1 (E/D#), U12.4 (Vdd); also elsewhere on the board
/3V3_RAW: U5.P7 (VBAT); also elsewhere on the board
/GND: C68.2, C69.2, C70.2, C71.2, C72.2, C73.2, C74.2, C78.2, C79.2, C80.2, C81.2, C82.2, C83.2, C84.2, C85.2, C86.2, C87.2, C88.2, C89.2, C90.2, C91.2, C92.2, C93.2, C94.2, C98.2, C99.2, C100.2, C101.2, C102.2, C103.2, C104.2, C105.2, C106.2, C107.2, C108.2, C109.2, C110.2, C111.2, C112.2, C113.2, C114.2, C117.2, C118.2, C119.2, C120.2, C121.2, C122.2, C123.2, C128.2, C140.2, C267.2, C268.2, C269.2, C270.2, C271.2, C272.2, C273.2, C274.2, J5.3 (GND), J5.5 (GND), J5.9 (GNDdet), J5.11 (GND), J5.13 (GND), J5.15 (GND), J5.17 (GND), J5.19 (GND), TP11.2 (Ext), TP13.2 (Ext), U5.A1 (VSS), U5.A22 (VSS), U5.AB1 (VSS), U5.AB22 (VSS), U5.E5 (VSS), U5.G6 (VSS), U5.H8 (VSS), U5.H10 (VSS), U5.H12 (VSS), U5.H14 (VSS), U5.H16 (VSS), U5.J9 (VSS), U5.J11 (VSS), U5.J13 (VSS), U5.J15 (VSS), U5.K10 (VSS), U5.K12 (VSS), U5.K14 (VSS), U5.L9 (VSS), U5.L11 (VSS), U5.L13 (VSS), U5.L15 (VSS), U5.M7 (VSSAON), U5.M10 (VSS), U5.M12 (VSS), U5.M14 (VSS), U5.M20 (VSS), U5.N7 (VSS), U5.N9 (VSS), U5.N11 (VSS), U5.N13 (VSS), U5.N15 (VSS), U5.P8 (VSS), U5.P10 (VSS), U5.P12 (VSS), U5.P14 (VSS), U5.R9 (VSS), U5.R11 (VSS), U5.R13 (VSS), U5.R15 (VSS), U5.T4 (VSS), U5.T16 (VDD33UCPD), U5.U6 (VSS), U5.U7 (VSSA), U5.V5 (ANA0), U5.V6 (ANA1), U5.W5 (VREF-), U5.W8 (VSS), U5.W16 (VSS), U5.W19 (VSS), U5.Y16 (VDD33USB), U12.2 (Vss); also elsewhere on the board
/Power supply/SOC_BOOT0: U5.R4 (BOOT0); also elsewhere on the board
/Power supply/SOC_BOOT1: U5.R3 (BOOT1); also elsewhere on the board
/Power supply/SOC_BOOT2: U5.T2 (BOOT2); also elsewhere on the board
/Power supply/SOC_BOOT3: U5.T1 (BOOT3); also elsewhere on the board
/Power supply/SOC_NRST1CMS: U5.T3 (NRSTC1MS); also elsewhere on the board
/Power supply/SOC_PWR_CPU_ON: U5.T6 (PWR_CPU_ON); also elsewhere on the board
/Power supply/SOC_PWR_LP: U5.U4 (PWR_LP); also elsewhere on the board
/Power supply/SOC_PWR_ON: U5.T5 (PWR_ON); also elsewhere on the board
/SoC support/A1V8: C267.1, C268.1, C269.1, C270.1, C271.1, C272.1, C273.1, C274.1, FB8.2, R40.2, TP13.1 (In), U5.C4 (VDDA18LVDS), U5.C7 (VDDA18DSI), U5.F6 (VDDA18CSI), U5.G17 (VDDA18PLL1), U5.J16 (VDDA18DDR), U5.K8 (VDDA18PLL2), U5.L8 (VDDA18PLL3), U5.W18 (VDDA18COMBOPHY)
/SoC support/SOC_CLK_25MHZ: R39.1, U5.V3 (OSC_IN)
/SoC support/SOC_JTAG_TCK: J5.4 (TCK), U5.AA1 (JTCK)
/SoC support/SOC_JTAG_TDI: J5.8 (TDI), U5.AB2 (JTDI)
/SoC support/SOC_JTAG_TDO: J5.6 (TDO), R43.2
/SoC support/SOC_JTAG_TMS: J5.2 (TMS), U5.Y1 (JTMS)
/SoC support/SOC_RST_N: J5.10 (~RST), R42.1, U5.U3 (NRST); also elsewhere on the board
/SoC support/TRACECLK: J5.12 (TRACECLK); also elsewhere on the board
/SoC support/TRACED0: J5.14 (TRACED0); also elsewhere on the board
/SoC support/TRACED1: J5.16 (TRACED1); also elsewhere on the board
/SoC support/TRACED2: J5.18 (TRACED2); also elsewhere on the board
/SoC support/TRACED3: J5.20 (TRACED3); also elsewhere on the board
/SoC support/V08CAP: C117.1, TP11.1 (In), U5.M8 (V08CAP)
/SoC support/VDDA18ADC: C123.1, C128.1, FB7.2, U5.V7 (VDDA18ADC)
unnamed: R45.1, U5.V2 (OSC_OUT)
unnamed: R40.1, U5.Y5 (VREF+)
unnamed: R43.1, U5.W1 (JTDO)
unnamed: R41.1, U5.AA2 (NJTRST)
unnamed: R39.2, U12.3 (CLK)

Notes on the sheet:
VDD (datasheet only calls for 5, do one per pin to be conservative). -44% delta for GRM155R70J105KA12 gives ~660 nF effective
SoC debug / reset / straps
Decoupling
SEQUENCING REQUIREMENTS VDDA18AON and VDD must ramp simultaneously (<1 ms) before any other rail VDD before VDDCPU VDD before VDDCORE VDD before VDDGPU IGNORED (USB disabled, tied off per HW dev guide table 6): * VDD33USB requires VDDA18USB * VDDA18USB and/or VDDA33USB requires VDDCORE
VDDIOx Datasheet calls for 1 per bank, do one extra to be conservative (tried one per ball but pinout didn't fit well)
Voltage level for the clock is Vsw This is Vdd during normal operation and Vbat in powerdown so 3.3V levels
SoC power
VDDCPU
VDDA18AON, VDD: simultaneous and first * VDD is 3V3 * VDDA18AON LDO from 3V3
VDDQDDR
JTAG is VDD domain (3v3)
A1V8
VDDA18ADC
SoC input clock
VDDCORE Datasheet calls for 6 caps Do 7 (one per ball) to be conservative
VDDGPU Not planning to use the GPU but hook power up just in case we want to play with it
All control IOs in VDD power domain (3v3) except PDR_ON * NRSTC1MS: flash reset output * PDR_ON: tie to VDDA18AON (RM p. 837) * BOOT[3:0]: boot mode select driven by super * PWR_CPU_ON: output indicating CPU is on * PWR_LP: output indicating low power mode * PWR_ON: output indicating either?
VDDCSI/DSI/LVDS etc Datasheet calls for 0.1 uF, do 1 for commonality w/ other stuff
Don't bother with noise filtering on CSI, DDR, DSI, LVDS inputs since we are not using those we don't care Tied USB rails to ground per HW dev guide table 6 These have special sequencing rules if used

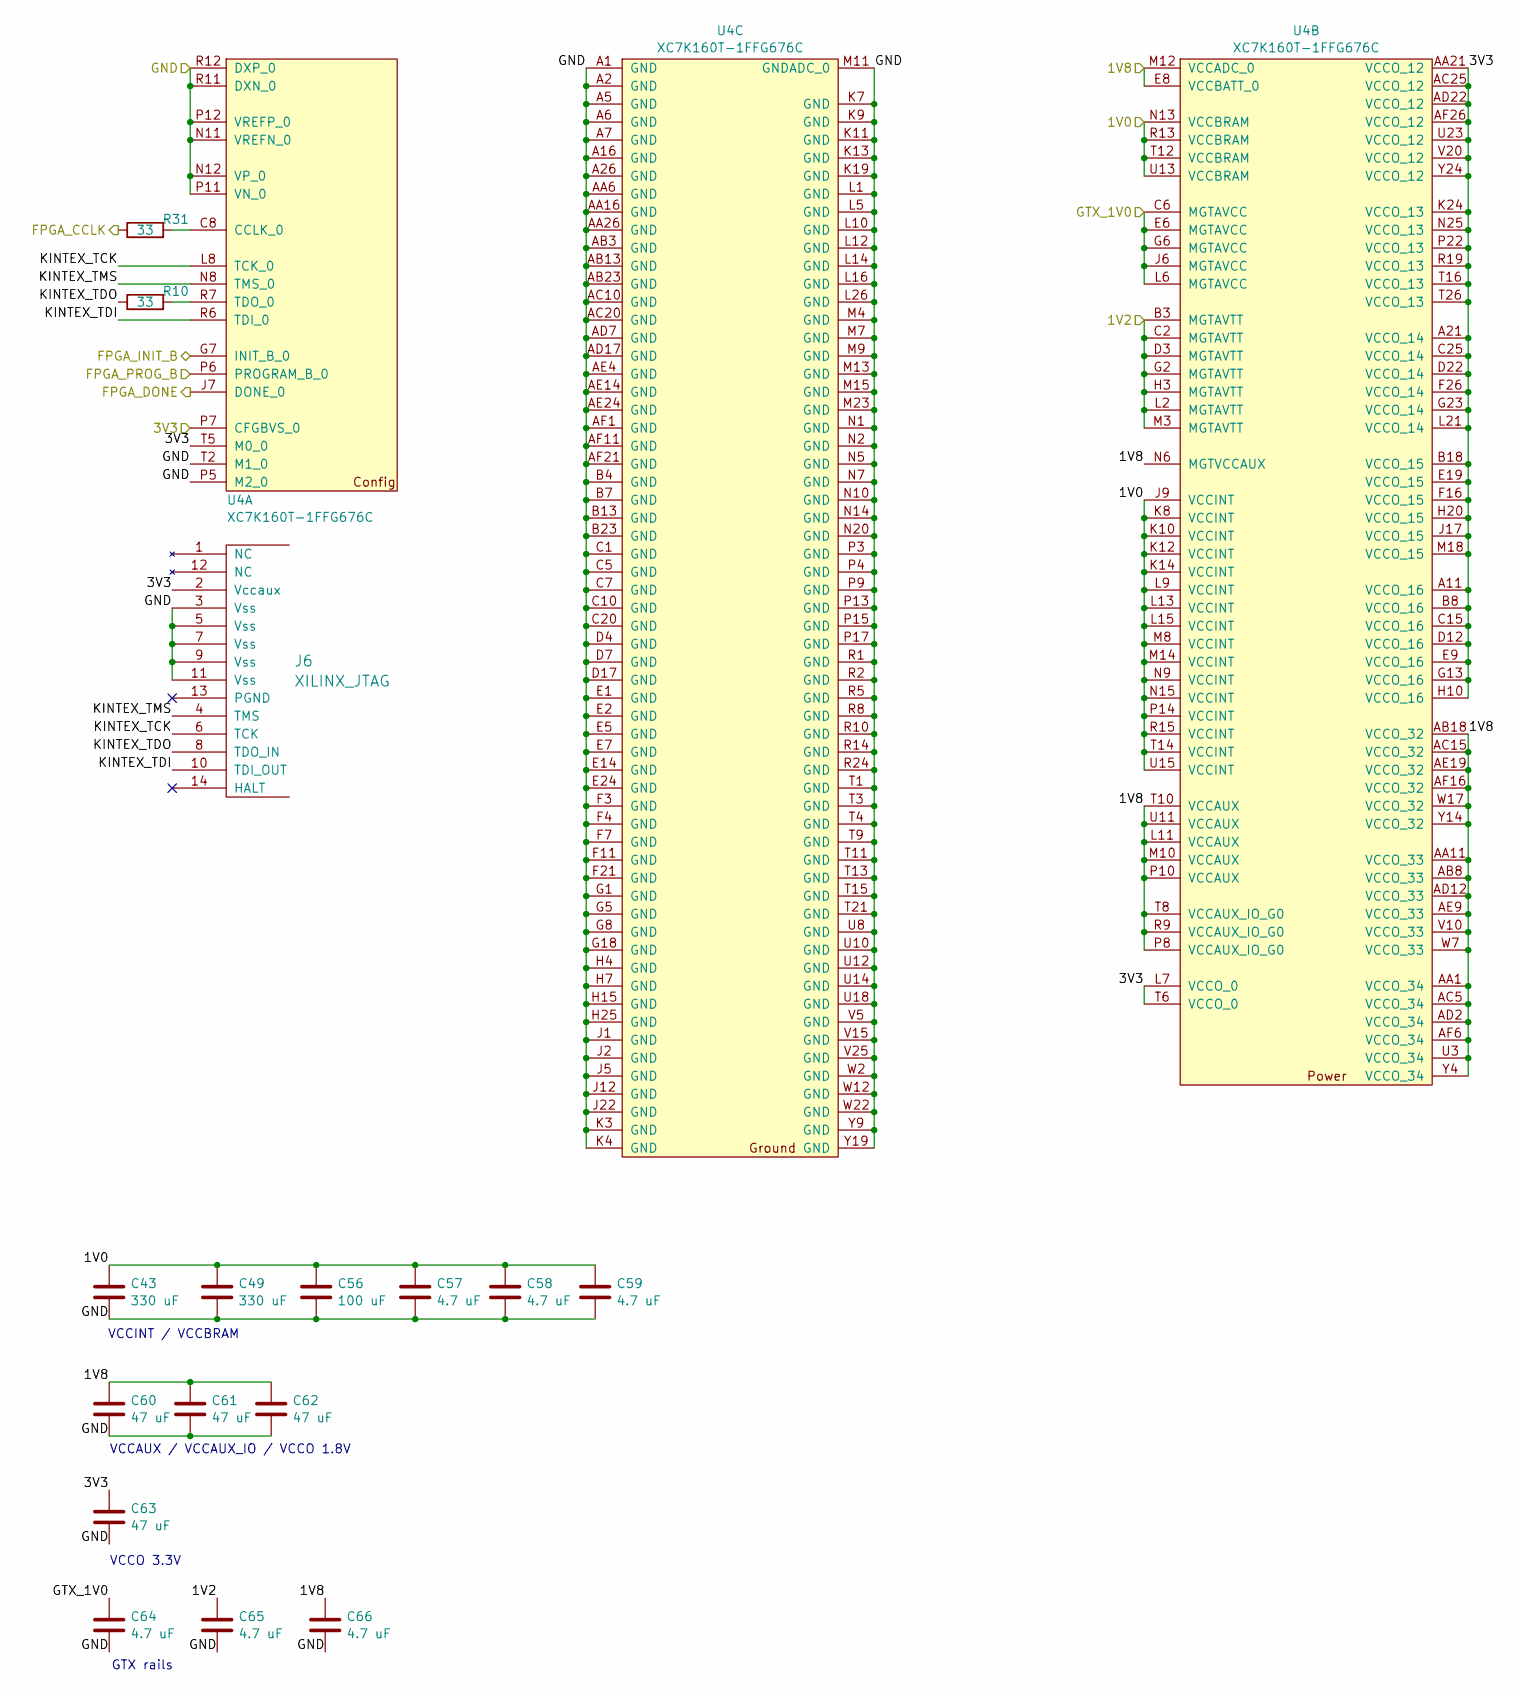
[picture p7: schematic fpgasupport.kicad_sch]

Parts:
C43, C49: 330 uF; EIA_1210_CAP_NOSILK
C56: 100 uF; EIA_1210_CAP_NOSILK
C57, C58, C59, C64, C65, C66: 4.7 uF; EIA_0603_CAP_NOSILK
C60, C61, C62, C63: 47 uF; EIA_1210_CAP_NOSILK
J6: XILINX_JTAG; XILINX_JTAG_PTH_MOLEX_0878311420
R10, R31: 33; EIA_0402_RES_NOSILK
U4: XC7K160T-1FFG676C; BGA_676_27x27_FULLARRAY_1MM_FFG676

Connections:
/1V2: C65.1, U4.B3 (MGTAVTT), U4.C2 (MGTAVTT), U4.D3 (MGTAVTT), U4.G2 (MGTAVTT), U4.H3 (MGTAVTT), U4.L2 (MGTAVTT), U4.M3 (MGTAVTT); also elsewhere on the board
/1V8: C60.1, C61.1, C62.1, C66.1, U4.AA1 (VCCO_34), U4.AA11 (VCCO_33), U4.AB8 (VCCO_33), U4.AB18 (VCCO_32), U4.AC5 (VCCO_34), U4.AC15 (VCCO_32), U4.AD2 (VCCO_34), U4.AD12 (VCCO_33), U4.AE9 (VCCO_33), U4.AE19 (VCCO_32), U4.AF6 (VCCO_34), U4.AF16 (VCCO_32), U4.E8 (VCCBATT_0), U4.L11 (VCCAUX), U4.M10 (VCCAUX), U4.M12 (VCCADC_0), U4.N6 (MGTVCCAUX), U4.P8 (VCCAUX_IO_G0), U4.P10 (VCCAUX), U4.R9 (VCCAUX_IO_G0), U4.T8 (VCCAUX_IO_G0), U4.T10 (VCCAUX), U4.U3 (VCCO_34), U4.U11 (VCCAUX), U4.V10 (VCCO_33), U4.W7 (VCCO_33), U4.W17 (VCCO_32), U4.Y4 (VCCO_34), U4.Y14 (VCCO_32); also elsewhere on the board
/3V3: C63.1, J6.2 (Vccaux), U4.A11 (VCCO_16), U4.A21 (VCCO_14), U4.AA21 (VCCO_12), U4.AC25 (VCCO_12), U4.AD22 (VCCO_12), U4.AF26 (VCCO_12), U4.B8 (VCCO_16), U4.B18 (VCCO_15), U4.C15 (VCCO_16), U4.C25 (VCCO_14), U4.D12 (VCCO_16), U4.D22 (VCCO_14), U4.E9 (VCCO_16), U4.E19 (VCCO_15), U4.F16 (VCCO_15), U4.F26 (VCCO_14), U4.G13 (VCCO_16), U4.G23 (VCCO_14), U4.H10 (VCCO_16), U4.H20 (VCCO_15), U4.J17 (VCCO_15), U4.K24 (VCCO_13), U4.L7 (VCCO_0), U4.L21 (VCCO_14), U4.M18 (VCCO_15), U4.N25 (VCCO_13), U4.P7 (CFGBVS_0), U4.P22 (VCCO_13), U4.R19 (VCCO_13), U4.T5 (M0_0), U4.T6 (VCCO_0), U4.T16 (VCCO_13), U4.T26 (VCCO_13), U4.U23 (VCCO_12), U4.V20 (VCCO_12), U4.Y24 (VCCO_12); also elsewhere on the board
/FPGA support/1V0: C43.1, C49.1, C56.1, C57.1, C58.1, C59.1, U4.J9 (VCCINT), U4.K8 (VCCINT), U4.K10 (VCCINT), U4.K12 (VCCINT), U4.K14 (VCCINT), U4.L9 (VCCINT), U4.L13 (VCCINT), U4.L15 (VCCINT), U4.M8 (VCCINT), U4.M14 (VCCINT), U4.N9 (VCCINT), U4.N13 (VCCBRAM), U4.N15 (VCCINT), U4.P14 (VCCINT), U4.R13 (VCCBRAM), U4.R15 (VCCINT), U4.T12 (VCCBRAM), U4.T14 (VCCINT), U4.U13 (VCCBRAM), U4.U15 (VCCINT); also elsewhere on the board
/FPGA support/FPGA_CCLK: R31.1; also elsewhere on the board
/FPGA support/FPGA_DONE: U4.J7 (DONE_0); also elsewhere on the board
/FPGA support/FPGA_INIT_B: U4.G7 (INIT_B_0); also elsewhere on the board
/FPGA support/FPGA_PROG_B: U4.P6 (PROGRAM_B_0); also elsewhere on the board
/FPGA support/GTX_1V0: C64.1, U4.C6 (MGTAVCC), U4.E6 (MGTAVCC), U4.G6 (MGTAVCC), U4.J6 (MGTAVCC), U4.L6 (MGTAVCC); also elsewhere on the board
/FPGA support/KINTEX_TCK: J6.6 (TCK), U4.L8 (TCK_0)
/FPGA support/KINTEX_TDI: J6.10 (TDI_OUT), U4.R6 (TDI_0)
/FPGA support/KINTEX_TDO: J6.8 (TDO_IN), R10.1
/FPGA support/KINTEX_TMS: J6.4 (TMS), U4.N8 (TMS_0)
/GND: C43.2, C49.2, C56.2, C57.2, C58.2, C59.2, C60.2, C61.2, C62.2, C63.2, C64.2, C65.2, C66.2, J6.3 (Vss), J6.5 (Vss), J6.7 (Vss), J6.9 (Vss), J6.11 (Vss), U4.A1 (GND), U4.A2 (GND), U4.A5 (GND), U4.A6 (GND), U4.A7 (GND), U4.A16 (GND), U4.A26 (GND), U4.AA6 (GND), U4.AA16 (GND), U4.AA26 (GND), U4.AB3 (GND), U4.AB13 (GND), U4.AB23 (GND), U4.AC10 (GND), U4.AC20 (GND), U4.AD7 (GND), U4.AD17 (GND), U4.AE4 (GND), U4.AE14 (GND), U4.AE24 (GND), U4.AF1 (GND), U4.AF11 (GND), U4.AF21 (GND), U4.B4 (GND), U4.B7 (GND), U4.B13 (GND), U4.B23 (GND), U4.C1 (GND), U4.C5 (GND), U4.C7 (GND), U4.C10 (GND), U4.C20 (GND), U4.D4 (GND), U4.D7 (GND), U4.D17 (GND), U4.E1 (GND), U4.E2 (GND), U4.E5 (GND), U4.E7 (GND), U4.E14 (GND), U4.E24 (GND), U4.F3 (GND), U4.F4 (GND), U4.F7 (GND), U4.F11 (GND), U4.F21 (GND), U4.G1 (GND), U4.G5 (GND), U4.G8 (GND), U4.G18 (GND), U4.H4 (GND), U4.H7 (GND), U4.H15 (GND), U4.H25 (GND), U4.J1 (GND), U4.J2 (GND), U4.J5 (GND), U4.J12 (GND), U4.J22 (GND), U4.K3 (GND), U4.K4 (GND), U4.K7 (GND), U4.K9 (GND), U4.K11 (GND), U4.K13 (GND), U4.K19 (GND), U4.L1 (GND), U4.L5 (GND), U4.L10 (GND), U4.L12 (GND), U4.L14 (GND), U4.L16 (GND), U4.L26 (GND), U4.M4 (GND), U4.M7 (GND), U4.M9 (GND), U4.M11 (GNDADC_0), U4.M13 (GND), U4.M15 (GND), U4.M23 (GND), U4.N1 (GND), U4.N2 (GND), U4.N5 (GND), U4.N7 (GND), U4.N10 (GND), U4.N11 (VREFN_0), U4.N12 (VP_0), U4.N14 (GND), U4.N20 (GND), U4.P3 (GND), U4.P4 (GND), U4.P5 (M2_0), U4.P9 (GND), U4.P11 (VN_0), U4.P12 (VREFP_0), U4.P13 (GND), U4.P15 (GND), U4.P17 (GND), U4.R1 (GND), U4.R2 (GND), U4.R5 (GND), U4.R8 (GND), U4.R10 (GND), U4.R11 (DXN_0), U4.R12 (DXP_0), U4.R14 (GND), U4.R24 (GND), U4.T1 (GND), U4.T2 (M1_0), U4.T3 (GND), U4.T4 (GND), U4.T9 (GND), U4.T11 (GND), U4.T13 (GND), U4.T15 (GND), U4.T21 (GND), U4.U8 (GND), U4.U10 (GND), U4.U12 (GND), U4.U14 (GND), U4.U18 (GND), U4.V5 (GND), U4.V15 (GND), U4.V25 (GND), U4.W2 (GND), U4.W12 (GND), U4.W22 (GND), U4.Y9 (GND), U4.Y19 (GND); also elsewhere on the board
unnamed: R31.2, U4.C8 (CCLK_0)
unnamed: R10.2, U4.R7 (TDO_0)

Notes on the sheet:
VCCO 3.3V
GTX rails
VCCAUX / VCCAUX_IO / VCCO 1.8V
VCCINT / VCCBRAM

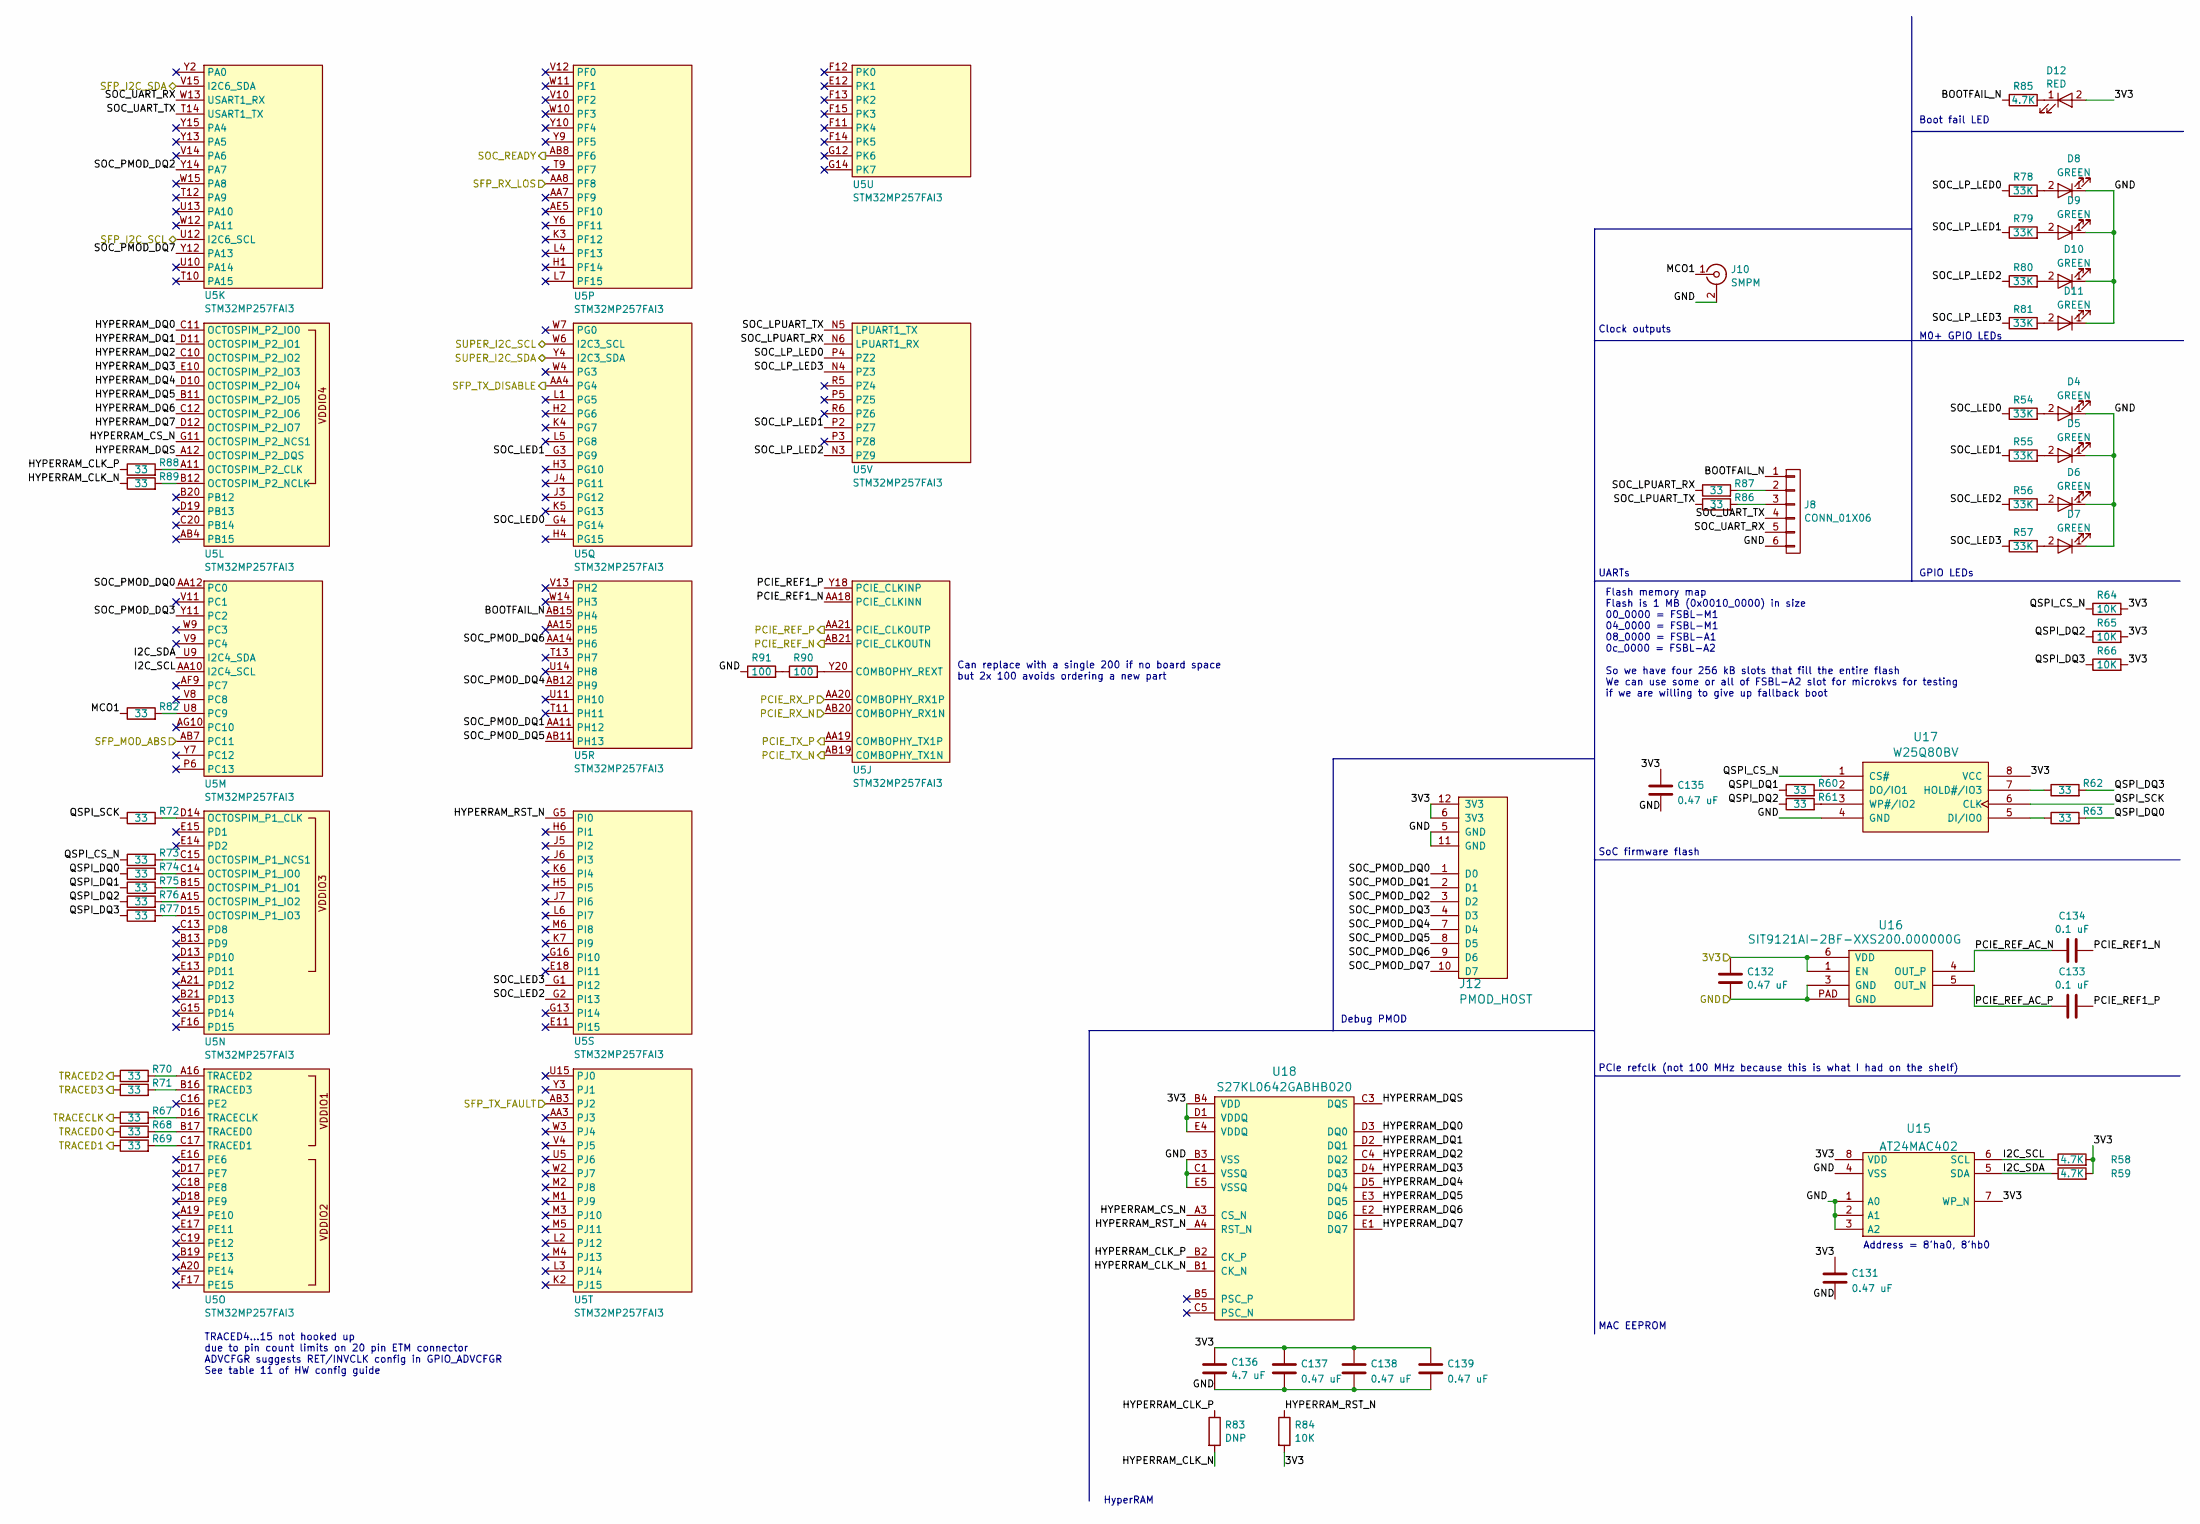
[picture p8: schematic soc.kicad_sch]

Parts:
C131, C132, C135, C137, C138, C139: 0.47 uF; EIA_0402_CAP_NOSILK
C133, C134: 0.1 uF; EIA_0402_CAP_NOSILK
C136: 4.7 uF; EIA_0603_CAP_NOSILK
D4, D5, D6, D7, D8, D9, D10, D11: GREEN; EIA_0402_LED
D12: RED; EIA_0402_LED
J8: CONN_01X06; CONN_HEADER_2.54MM_1x6_REFLOW
J10: SMPM; CONN_SMPM_AMPHENOL_C925-197J-51PT
J12: PMOD_HOST; CONN_HEADER_2.54MM_2x6_RA_PMOD_HOST
R54, R55, R56, R57, R78, R79, R80, R81: 33K; EIA_0402_RES_NOSILK
R58, R59, R85: 4.7K; EIA_0402_RES_NOSILK
R60, R61, R62, R63, R67, R68, R69, R70, R71, R72, R73, R74, R75, R76, R77, R82, R86, R87, R88, R89: 33; EIA_0402_RES_NOSILK
R64, R65, R66, R84: 10K; EIA_0402_RES_NOSILK
R83: DNP; EIA_0402_RES_NOSILK
R90, R91: 100; EIA_0402_RES_NOSILK
U5: STM32MP257FAI3; BGA_436_18x18_DEPOP_0.8MM
U15: AT24MAC402; DFN_8_0.5MM_2x3MM_TALL
U16: SIT9121AI-2BF-XXS200.000000G; OSCILLATOR_LVDS_3.2x2.5
U17: W25Q80BV; SOIC_8_5.3MM
U18: S27KL0642GABHB020; BGA_24_6x8_DEPOP1_1MM

Connections:
/3V3: C131.1, C132.1, C135.1, C136.1, C137.1, C138.1, C139.1, D12.2 (A), J12.6 (3V3), J12.12 (3V3), R58.2, R59.2, R64.2, R65.2, R66.2, R84.2, U15.7 (WP_N), U15.8 (VDD), U16.1 (EN), U16.6 (VDD), U17.8 (VCC), U18.B4 (VDD), U18.D1 (VDDQ), U18.E4 (VDDQ); also elsewhere on the board
/FPGA/PCIE_REF_N: U5.AB21 (PCIE_CLKOUTN); also elsewhere on the board
/FPGA/PCIE_REF_P: U5.AA21 (PCIE_CLKOUTP); also elsewhere on the board
/FPGA/PCIE_RX_N: U5.AB20 (COMBOPHY_RX1N); also elsewhere on the board
/FPGA/PCIE_RX_P: U5.AA20 (COMBOPHY_RX1P); also elsewhere on the board
/FPGA/PCIE_TX_N: U5.AB19 (COMBOPHY_TX1N); also elsewhere on the board
/FPGA/PCIE_TX_P: U5.AA19 (COMBOPHY_TX1P); also elsewhere on the board
/FPGA/SFP_I2C_SCL: U5.U12 (I2C6_SCL); also elsewhere on the board
/FPGA/SFP_I2C_SDA: U5.V15 (I2C6_SDA); also elsewhere on the board
/FPGA/SFP_MOD_ABS: U5.AB7 (PC11); also elsewhere on the board
/FPGA/SFP_RX_LOS: U5.AA8 (PF8); also elsewhere on the board
/FPGA/SFP_TX_DISABLE: U5.AA4 (PG4); also elsewhere on the board
/FPGA/SFP_TX_FAULT: U5.AB3 (PJ2); also elsewhere on the board
/GND: C131.2, C132.2, C135.2, C136.2, C137.2, C138.2, C139.2, D4.1 (K), D5.1 (K), D6.1 (K), D7.1 (K), D8.1 (K), D9.1 (K), D10.1 (K), D11.1 (K), J8.6, J10.2 (Ext), J12.5 (GND), J12.11 (GND), R91.1, U15.1 (A0), U15.2 (A1), U15.3 (A2), U15.4 (VSS), U16.3 (GND), U16.PAD (GND), U17.4 (GND), U18.B3 (VSS), U18.C1 (VSSQ), U18.E5 (VSSQ); also elsewhere on the board
/Power supply/SOC_READY: U5.AB8 (PF6); also elsewhere on the board
/Power supply/SUPER_I2C_SCL: U5.W6 (I2C3_SCL); also elsewhere on the board
/Power supply/SUPER_I2C_SDA: U5.Y4 (I2C3_SDA); also elsewhere on the board
/SoC support/TRACECLK: R67.1; also elsewhere on the board
/SoC support/TRACED0: R68.1; also elsewhere on the board
/SoC support/TRACED1: R69.1; also elsewhere on the board
/SoC support/TRACED2: R70.1; also elsewhere on the board
/SoC support/TRACED3: R71.1; also elsewhere on the board
/SoC/BOOTFAIL_N: J8.1, R85.1, U5.AB15 (PH4)
/SoC/HYPERRAM_CLK_N: R83.2, R89.1, U18.B1 (CK_N)
/SoC/HYPERRAM_CLK_P: R83.1, R88.1, U18.B2 (CK_P)
/SoC/HYPERRAM_CS_N: U5.G11 (OCTOSPIM_P2_NCS1), U18.A3 (CS_N)
/SoC/HYPERRAM_DQ0: U5.C11 (OCTOSPIM_P2_IO0), U18.D3 (DQ0)
/SoC/HYPERRAM_DQ1: U5.D11 (OCTOSPIM_P2_IO1), U18.D2 (DQ1)
/SoC/HYPERRAM_DQ2: U5.C10 (OCTOSPIM_P2_IO2), U18.C4 (DQ2)
/SoC/HYPERRAM_DQ3: U5.E10 (OCTOSPIM_P2_IO3), U18.D4 (DQ3)
/SoC/HYPERRAM_DQ4: U5.D10 (OCTOSPIM_P2_IO4), U18.D5 (DQ4)
/SoC/HYPERRAM_DQ5: U5.B11 (OCTOSPIM_P2_IO5), U18.E3 (DQ5)
/SoC/HYPERRAM_DQ6: U5.C12 (OCTOSPIM_P2_IO6), U18.E2 (DQ6)
/SoC/HYPERRAM_DQ7: U5.D12 (OCTOSPIM_P2_IO7), U18.E1 (DQ7)
/SoC/HYPERRAM_DQS: U5.A12 (OCTOSPIM_P2_DQS), U18.C3 (DQS)
/SoC/HYPERRAM_RST_N: R84.1, U5.G5 (PI0), U18.A4 (RST_N)
/SoC/I2C_SCL: R58.1, U5.AA10 (I2C4_SCL), U15.6 (SCL)
/SoC/I2C_SDA: R59.1, U5.U9 (I2C4_SDA), U15.5 (SDA)
/SoC/MCO1: J10.1 (In), R82.1
/SoC/PCIE_REF1_N: C134.2, U5.AA18 (PCIE_CLKINN)
/SoC/PCIE_REF1_P: C133.2, U5.Y18 (PCIE_CLKINP)
/SoC/PCIE_REF_AC_N: C134.1, U16.4 (OUT_P)
/SoC/PCIE_REF_AC_P: C133.1, U16.5 (OUT_N)
/SoC/QSPI_CS_N: R64.1, R73.1, U17.1 (CS#)
/SoC/QSPI_DQ0: R63.2, R74.1
/SoC/QSPI_DQ1: R60.1, R75.1
/SoC/QSPI_DQ2: R61.1, R65.1, R76.1
/SoC/QSPI_DQ3: R62.2, R66.1, R77.1
/SoC/QSPI_SCK: R72.1, U17.6 (CLK)
/SoC/SOC_LED0: R54.1, U5.G4 (PG14)
/SoC/SOC_LED1: R55.1, U5.G3 (PG9)
/SoC/SOC_LED2: R56.1, U5.G2 (PI13)
/SoC/SOC_LED3: R57.1, U5.G1 (PI12)
/SoC/SOC_LPUART_RX: R87.1, U5.N6 (LPUART1_RX)
/SoC/SOC_LPUART_TX: R86.1, U5.N5 (LPUART1_TX)
/SoC/SOC_LP_LED0: R78.1, U5.P4 (PZ2)
/SoC/SOC_LP_LED1: R79.1, U5.P2 (PZ7)
/SoC/SOC_LP_LED2: R80.1, U5.N3 (PZ9)
/SoC/SOC_LP_LED3: R81.1, U5.N4 (PZ3)
/SoC/SOC_PMOD_DQ0: J12.1 (D0), U5.AA12 (PC0)
/SoC/SOC_PMOD_DQ1: J12.2 (D1), U5.AA11 (PH12)
/SoC/SOC_PMOD_DQ2: J12.3 (D2), U5.Y14 (PA7)
/SoC/SOC_PMOD_DQ3: J12.4 (D3), U5.Y11 (PC2)
/SoC/SOC_PMOD_DQ4: J12.7 (D4), U5.AB12 (PH9)
/SoC/SOC_PMOD_DQ5: J12.8 (D5), U5.AB11 (PH13)
/SoC/SOC_PMOD_DQ6: J12.9 (D6), U5.AA14 (PH6)
/SoC/SOC_PMOD_DQ7: J12.10 (D7), U5.Y12 (PA13)
/SoC/SOC_UART_RX: J8.5, U5.W13 (USART1_RX)
/SoC/SOC_UART_TX: J8.4, U5.T14 (USART1_TX)
unnamed: D4.2 (A), R54.2
unnamed: D5.2 (A), R55.2
unnamed: D6.2 (A), R56.2
unnamed: D7.2 (A), R57.2
unnamed: D8.2 (A), R78.2
unnamed: D9.2 (A), R79.2
unnamed: D10.2 (A), R80.2
unnamed: D11.2 (A), R81.2
unnamed: D12.1 (K), R85.2
unnamed: J8.2, R87.2
unnamed: J8.3, R86.2
unnamed: R90.1, R91.2
unnamed: R90.2, U5.Y20 (COMBOPHY_REXT)
unnamed: R88.2, U5.A11 (OCTOSPIM_P2_CLK)
unnamed: R89.2, U5.B12 (OCTOSPIM_P2_NCLK)
unnamed: R82.2, U5.U8 (PC9)
unnamed: R72.2, U5.D14 (OCTOSPIM_P1_CLK)
unnamed: R73.2, U5.C15 (OCTOSPIM_P1_NCS1)
unnamed: R74.2, U5.C14 (OCTOSPIM_P1_IO0)
unnamed: R75.2, U5.B15 (OCTOSPIM_P1_IO1)
unnamed: R76.2, U5.A15 (OCTOSPIM_P1_IO2)
unnamed: R77.2, U5.D15 (OCTOSPIM_P1_IO3)
unnamed: R70.2, U5.A16 (TRACED2)
unnamed: R71.2, U5.B16 (TRACED3)
unnamed: R67.2, U5.D16 (TRACECLK)
unnamed: R68.2, U5.B17 (TRACED0)
unnamed: R69.2, U5.C17 (TRACED1)
unnamed: R63.1, U17.5 (DI/IO0)
unnamed: R60.2, U17.2 (DO/IO1)
unnamed: R62.1, U17.7 (HOLD#/IO3)
unnamed: R61.2, U17.3 (WP#/IO2)

Notes on the sheet:
Debug PMOD
TRACED4...15 not hooked up due to pin count limits on 20 pin ETM connector ADVCFGR suggests RET/INVCLK config in GPIO_ADVCFGR See table 11 of HW config guide
SoC firmware flash
Can replace with a single 200 if no board space but 2x 100 avoids ordering a new part
Flash memory map Flash is 1 MB (0x0010_0000) in size 00_0000 = FSBL-M1 04_0000 = FSBL-M1 08_0000 = FSBL-A1 0c_0000 = FSBL-A2 So we have four 256 kB slots that fill the entire flash We can use some or all of FSBL-A2 slot for microkvs for testing if we are willing to give up fallback boot
M0+ GPIO LEDs
Address = 8'ha0, 8'hb0
Boot fail LED
HyperRAM
Clock outputs
PCIe refclk (not 100 MHz because this is what I had on the shelf)
GPIO LEDs
UARTs
MAC EEPROM

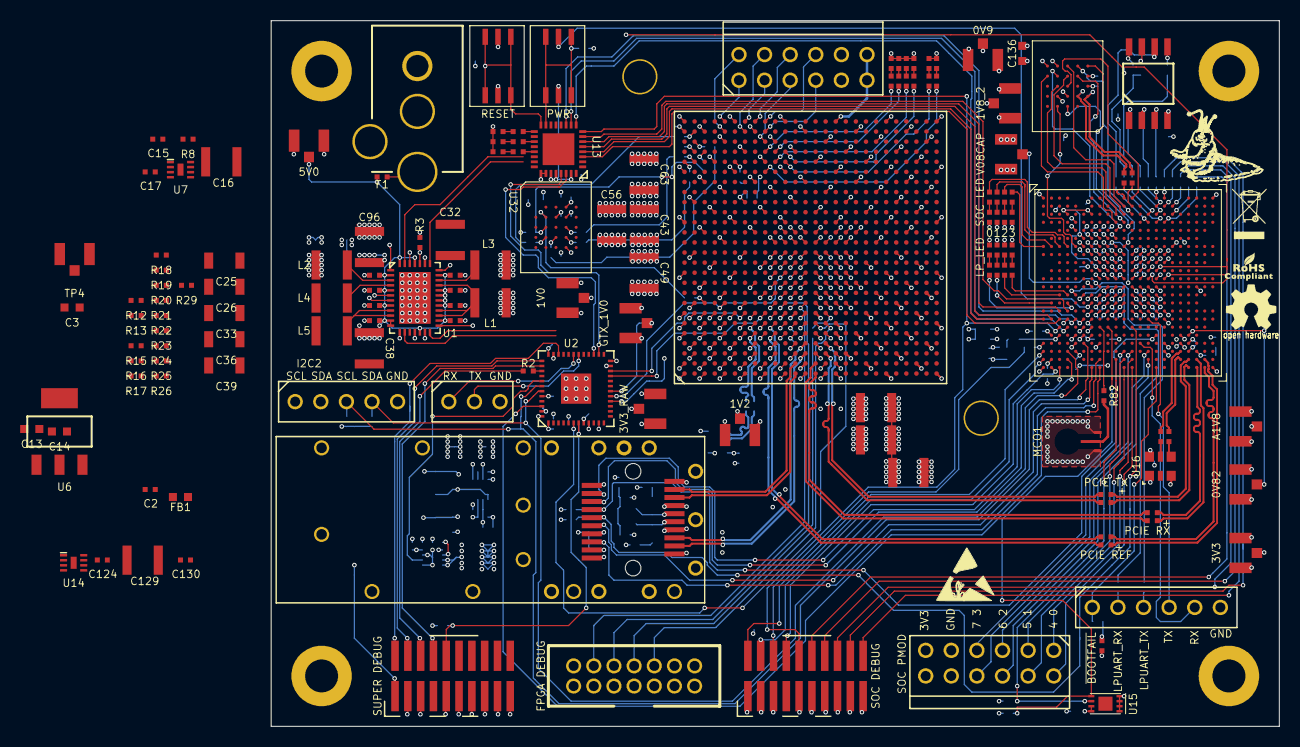
[picture p9: board mp2-xc7k-test.kicad_pcb from above]

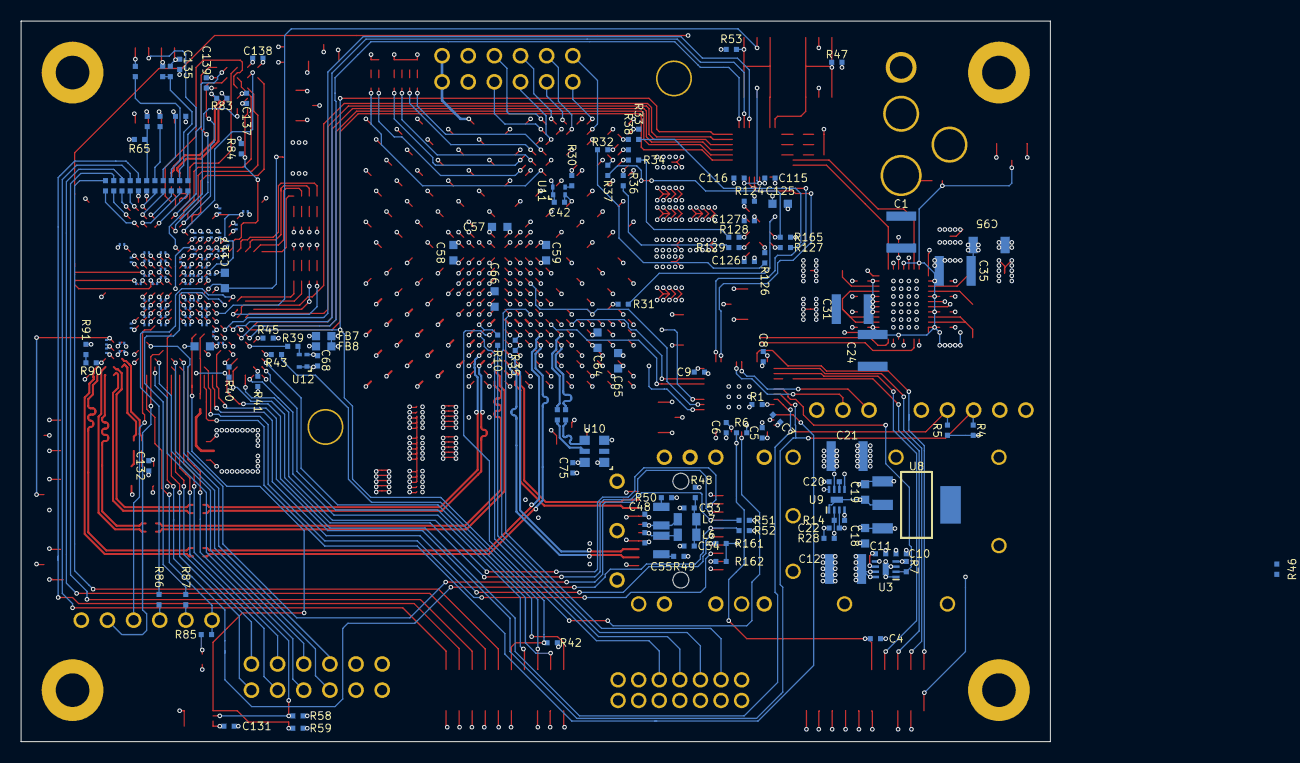
[picture p10: board mp2-xc7k-test.kicad_pcb from below]

Board: 4 copper layers, 100.0 x 70.0 mm, 334 parts (180 on the bottom side), 247 nets.
