azonenberg/stm32mp2-baremetal-tests/(commit log)

2025-11-16 Initial dummy LED firmware running on CPU2 via SWD runtime programming
2025-11-17 MP2 UART is now alive on testbed
2025-11-18 Now able to detect QSPI flash on the board
2025-11-19 Test firmware is now able to boot from spi flash
2025-12-07 Fixed typo in default hostname
    [TestCLISessionContext.cpp]
2025-12-07 Updated to latest stm32-cpp
2025-12-07 Current WIP PCIe bringup
2025-12-20 Initial version of test PCB schematic
    [clocking.kicad_sch, fpga.kicad_sch, fpgasupport.kicad_sch, mp2-xc7k-test.kicad_pcb, mp2-xc7k-test.kicad_sch, psu.kicad_sch, soc.kicad_sch, socsupport.kicad_sch]
2025-12-22 Continued layout, 454 unrouted
    [fpga.kicad_sch, fpgasupport.kicad_sch, mp2-xc7k-test.kicad_pcb, mp2-xc7k-test.kicad_sch, psu.kicad_sch, soc.kicad_sch, socsupport.kicad_sch, unused-io.kicad_sch]
2025-12-23 Continued PCB routing, 344 nets left
    [fpga.kicad_sch, mp2-xc7k-test.kicad_pcb, soc.kicad_sch, socsupport.kicad_sch]
2025-12-23 111 unrouted, getting close
    [fpga.kicad_sch, mp2-xc7k-test.kicad_pcb, psu.kicad_sch]
2025-12-26 Test board ready for design review
    [fpga.kicad_sch, fpgasupport.kicad_sch, mp2-xc7k-test.kicad_sch, psu.kicad_sch, soc.kicad_sch, socsupport.kicad_sch, unused-io.kicad_sch]
2025-12-26 Added missing ground plane cutouts under SFP+ SERDES pairs
2025-12-27 Changed L1 to larger, higher current NRS5030. Reduced inductance from 2.2 uH to 1 per datasheet recommendations
    [psu.kicad_sch]
2025-12-27 Schematic review complete, added a few more test points
    [mp2-xc7k-test.kicad_sch, psu.kicad_sch]
2025-12-27 Added 1V8_SOC load switch
    [fpga.kicad_sch, fpgasupport.kicad_sch, mp2-xc7k-test.kicad_sch, psu.kicad_sch, soc.kicad_sch, socsupport.kicad_sch, unused-io.kicad_sch]
2025-12-27 Final MP2 XC7K test board ready for fab
    [fpga.kicad_sch, socsupport.kicad_sch]
2025-12-28 Fixed bad pullup value. Added PnP fixture
    [fpga.kicad_sch]
